javierfileiv/gaspetto/datasheet/YP-05-serial-usb-pinout.png

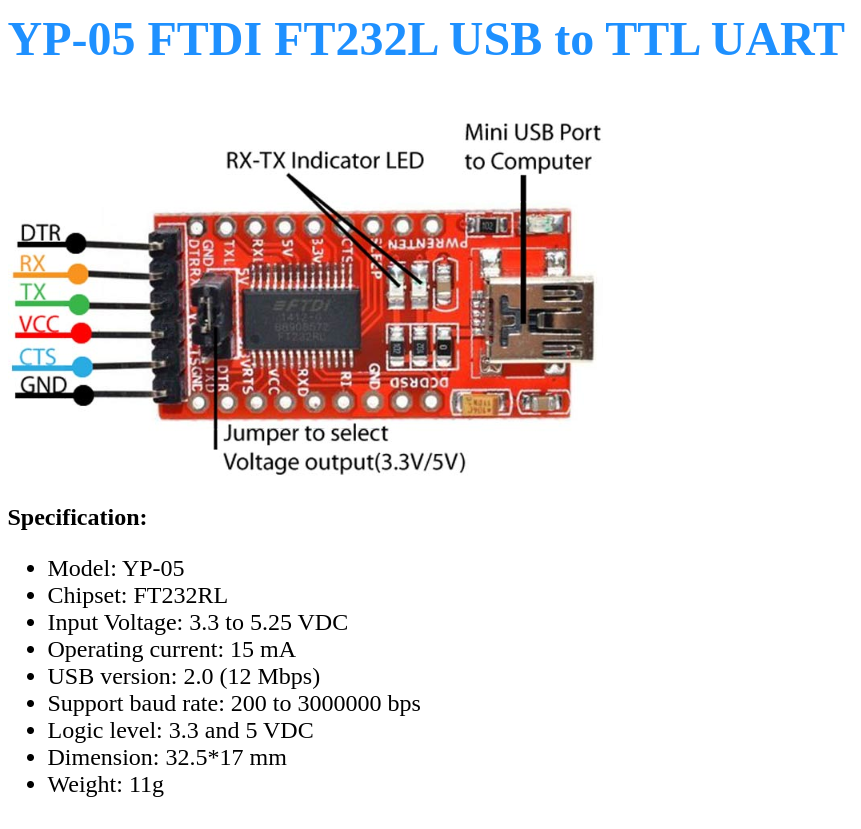
datasheet/YP-05-serial-usb-pinout.png
