javierfileiv/gaspetto/datasheet/convertisseur.png

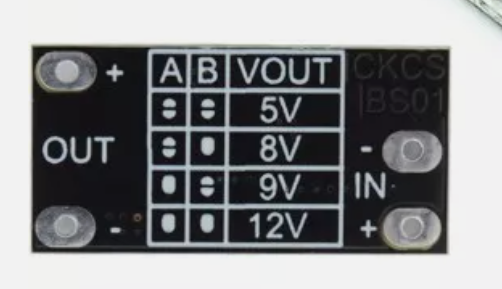
datasheet/convertisseur.png
