javierfileiv/gaspetto/datasheet/blackpill limitation.png

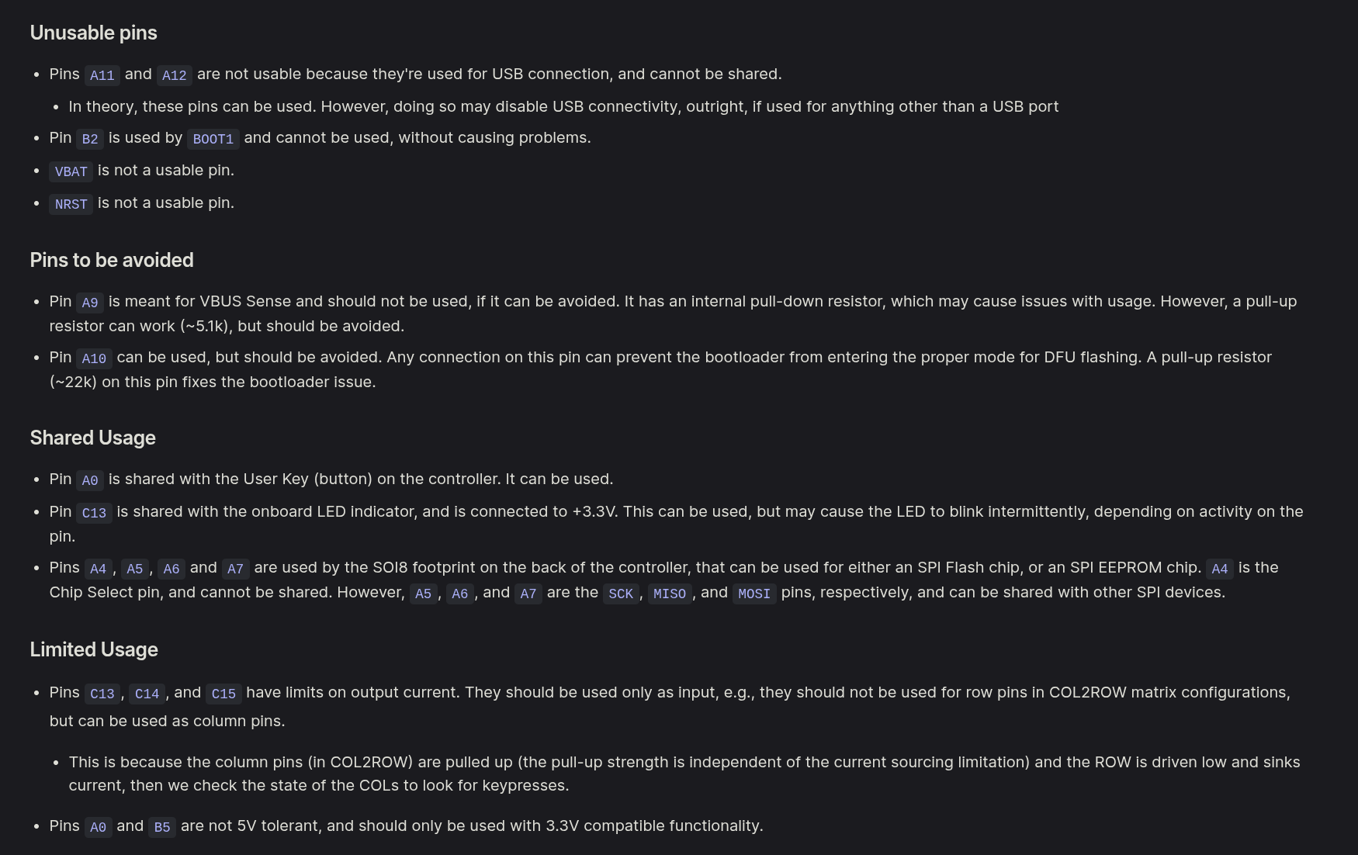
datasheet/blackpill limitation.png
