javierfileiv/gaspetto/datasheet/bluepill_sch.jpg

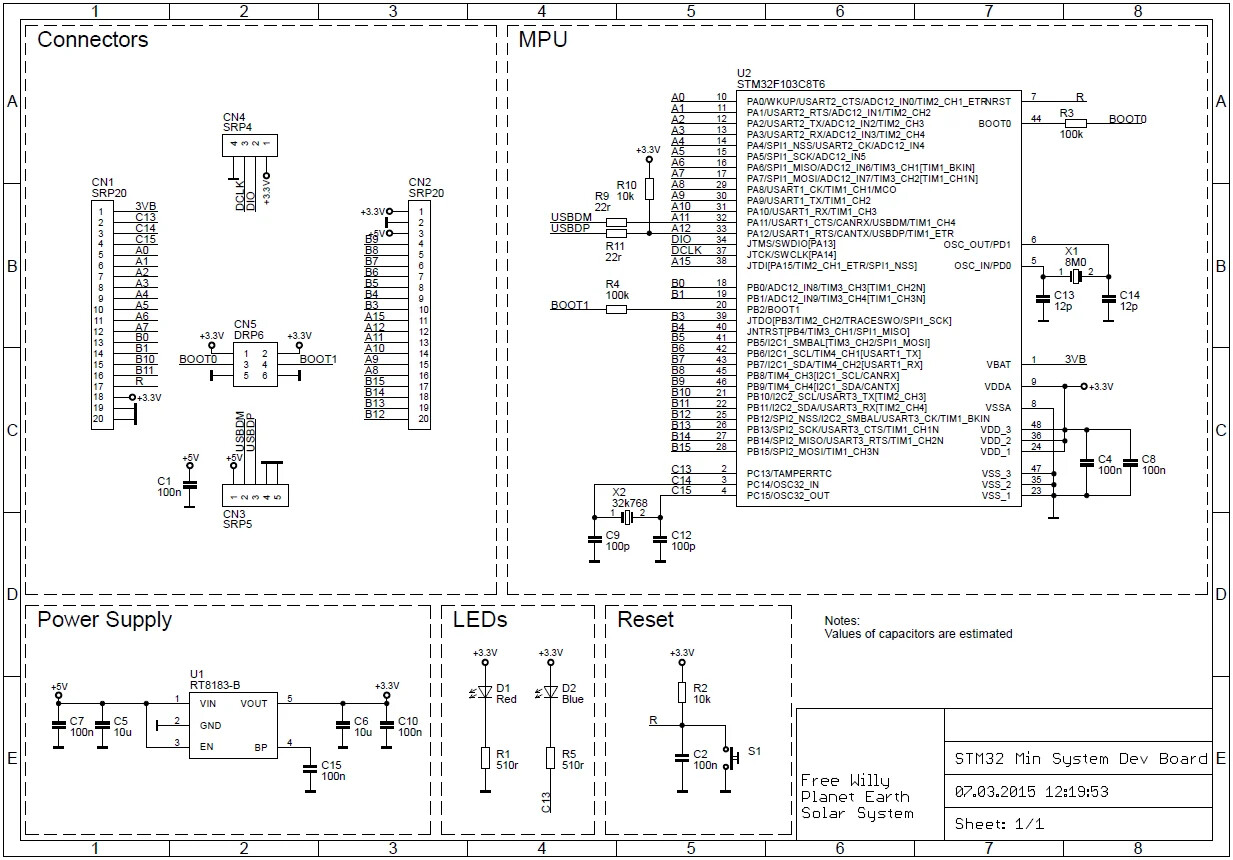
datasheet/bluepill_sch.jpg
