javierfileiv/gaspetto/datasheet/interface bluepill nrf.png

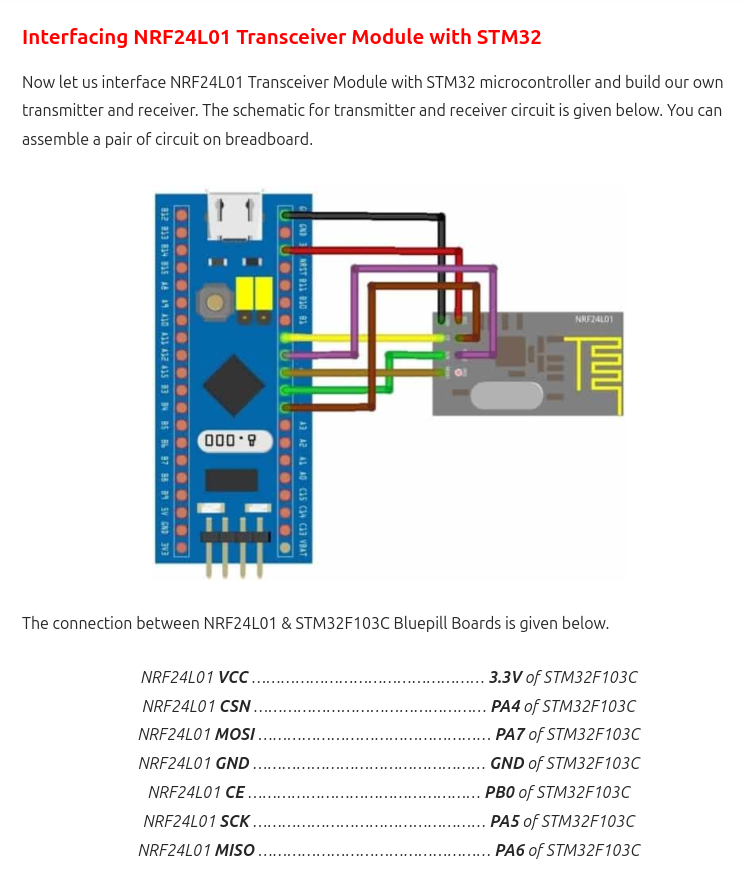
datasheet/interface bluepill nrf.png
