javierfileiv/gaspetto/datasheet/L9110-possible-sch.png

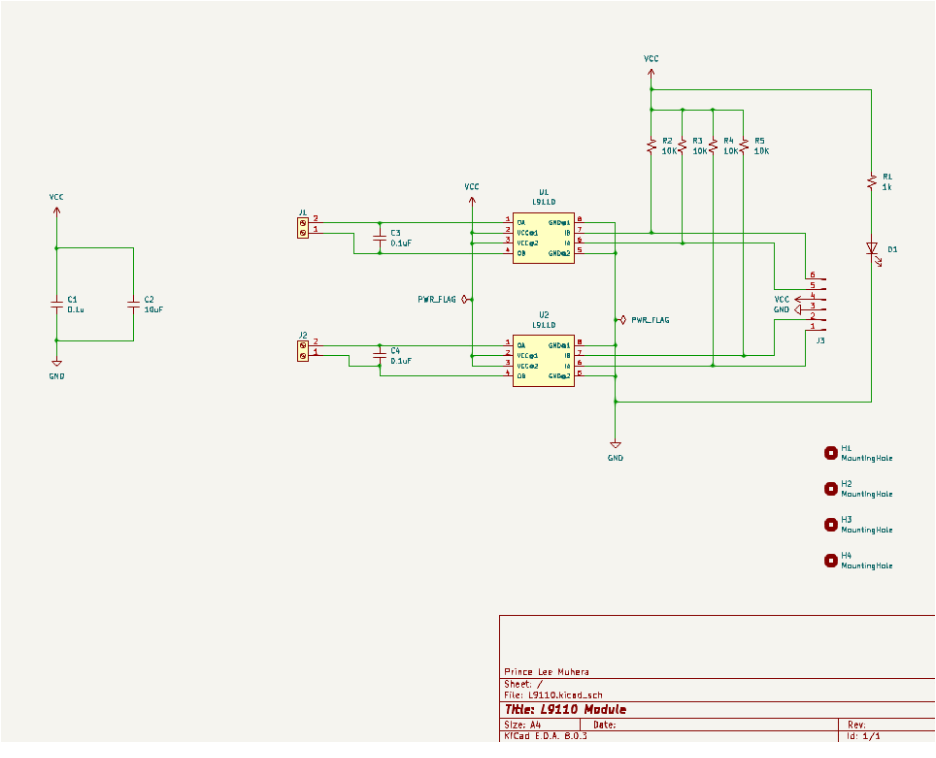
datasheet/L9110-possible-sch.png
