javierfileiv/gaspetto/datasheet/L9110-puenteH.png

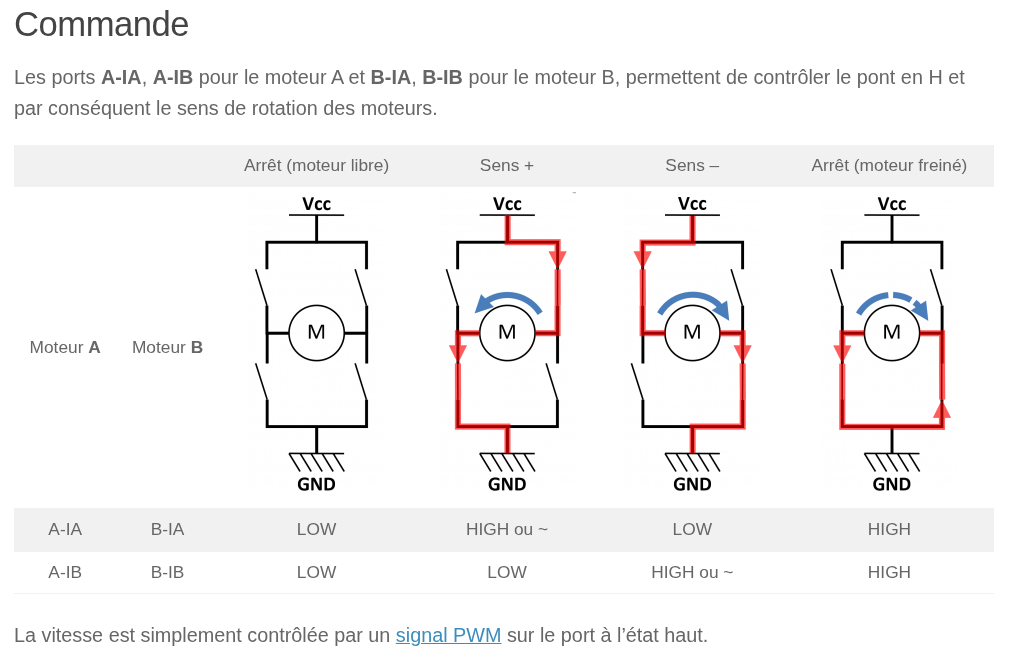
datasheet/L9110-puenteH.png
