javierfileiv/gaspetto/datasheet/l9110_breakout.jpg

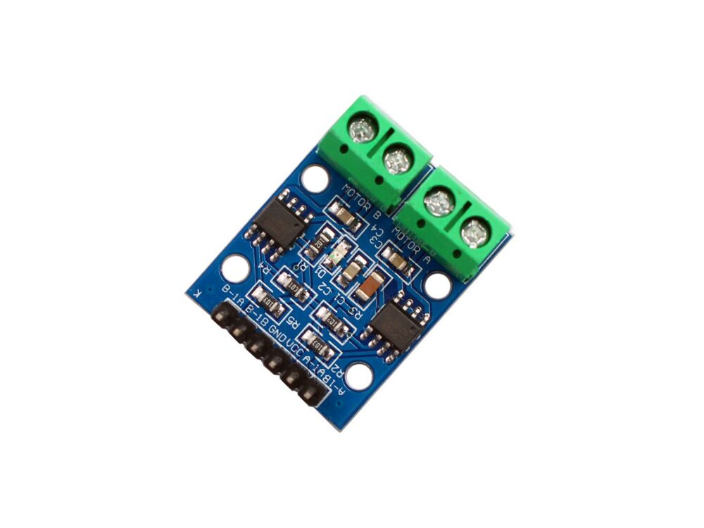
datasheet/l9110_breakout.jpg
