javierfileiv/gaspetto/datasheet/NRF24L01-pinout.png

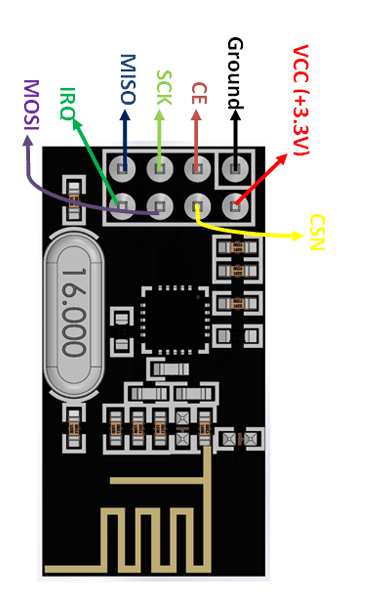
datasheet/NRF24L01-pinout.png
