javierfileiv/gaspetto/datasheet/optical_speed_sensor.png

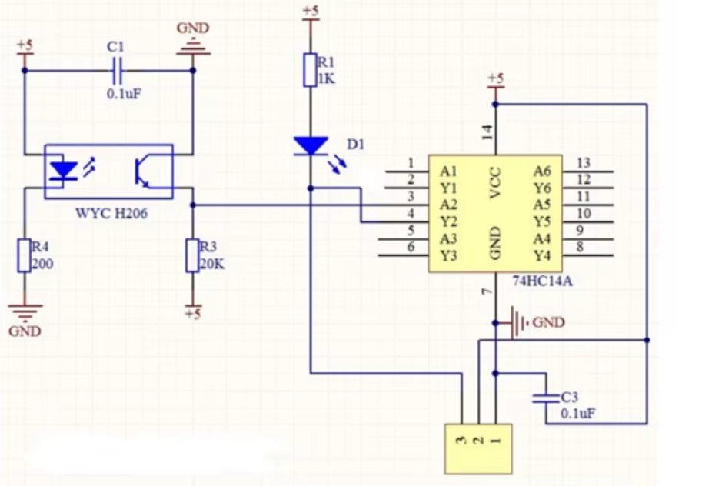
datasheet/optical_speed_sensor.png
