javierfileiv/gaspetto/datasheet/Speed Measuring Sensor- Encoder Counter.png

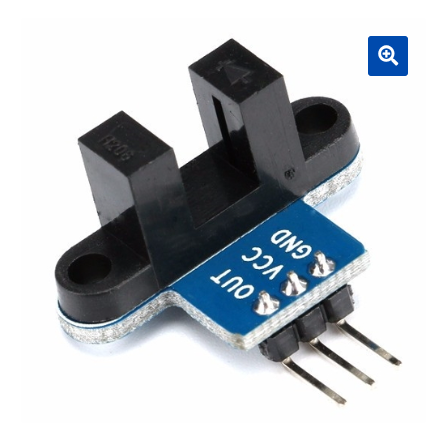
datasheet/Speed Measuring Sensor- Encoder Counter.png
