javierfileiv/gaspetto/FreeCad/Franco/Plan de travail 1.jpg

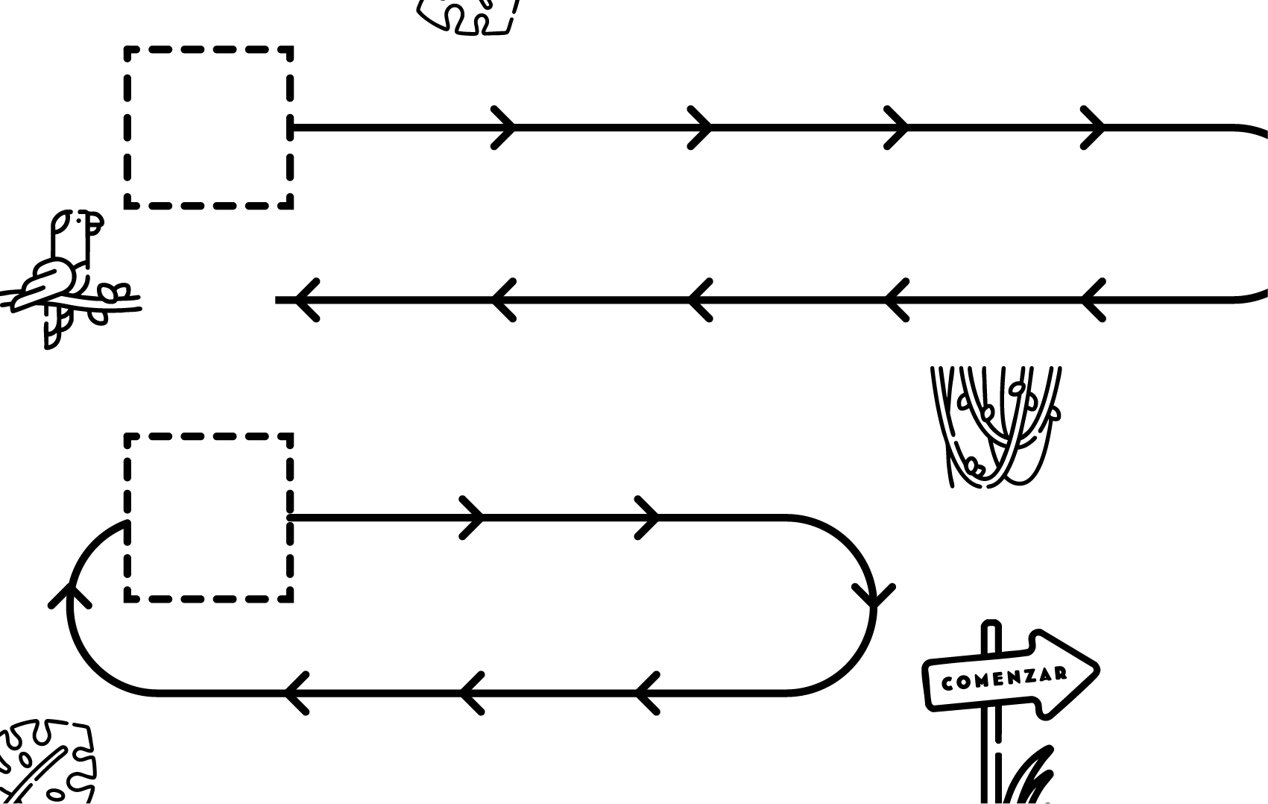
FreeCad/Franco/Plan de travail 1.jpg
