javierfileiv/gaspetto/FreeCad/Franco/Plan de travail 3.jpg

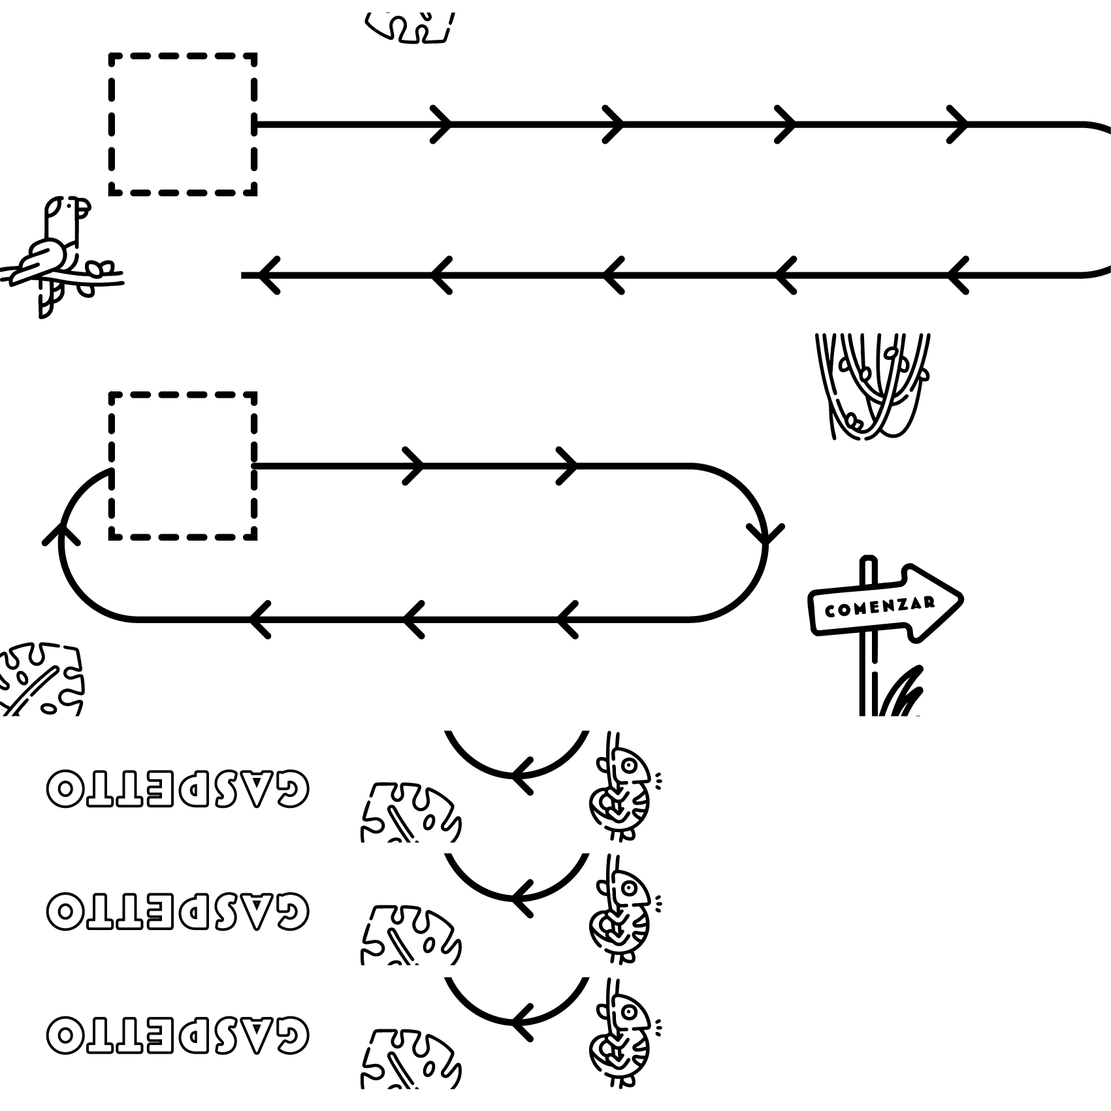
FreeCad/Franco/Plan de travail 3.jpg
