javierfileiv/gaspetto/FreeCad/gaspetto-box.FCStd

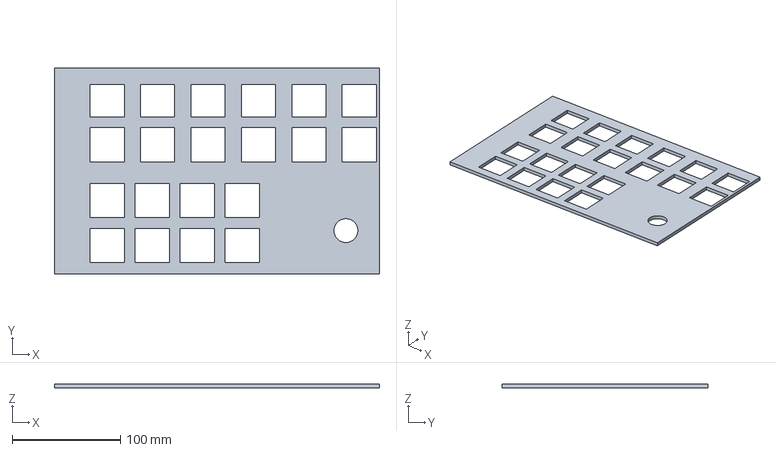
[picture p14: CAD file, 2026-04-30]
FreeCad/gaspetto-box.FCStd
300.0 x 190.0 x 4.00 mm
