javierfileiv/gaspetto/primo-prototype-laser/CubettoCloneBits/left_top2.stl

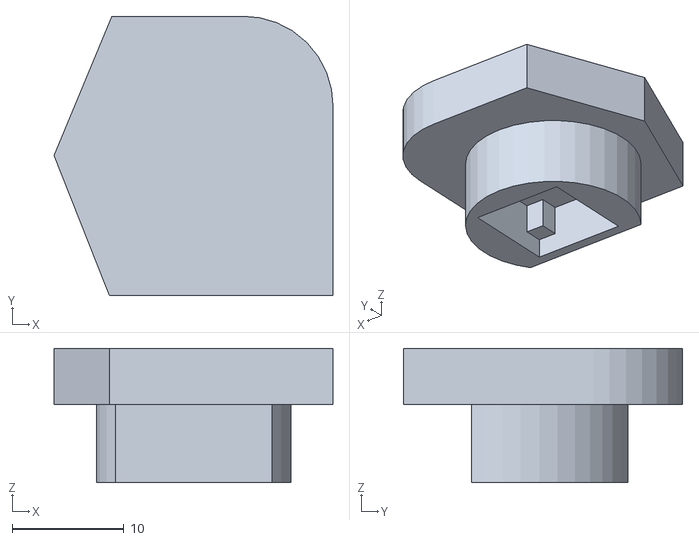
[picture p15: CAD file, 2023-08-26]
primo-prototype-laser/CubettoCloneBits/left_top2.stl
25.0 x 25.0 x 12.0
