javierfileiv/gaspetto/primo-prototype-laser/laser-cut-LibreCAD/original/tree-4mm.dxf

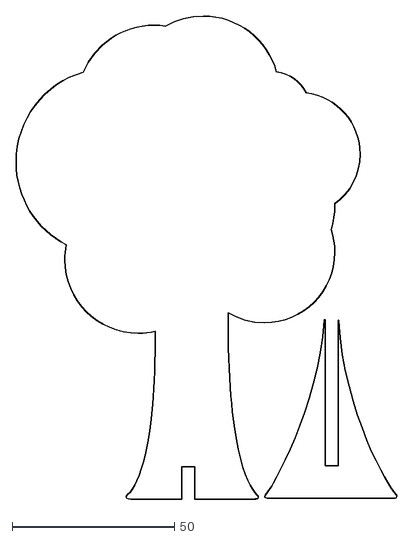
[picture p16: CAD file, 2023-08-26]
primo-prototype-laser/laser-cut-LibreCAD/original/tree-4mm.dxf
118.7 x 149.3
