javierfileiv/gaspetto/primo-prototype-laser/CubettoCloneBits/left_top_v2.stl

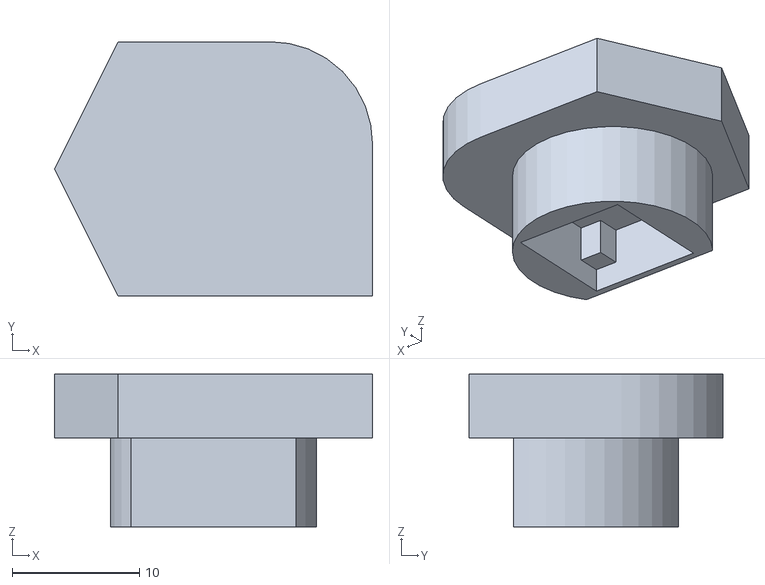
[picture p17: CAD file, 2023-08-26]
primo-prototype-laser/CubettoCloneBits/left_top_v2.stl
25.0 x 20.0 x 12.0
