javierfileiv/gaspetto/primo-prototype-laser/laser-cut-LibreCAD/InstructionsBlock/#instruction-blocks-1mm.dxf

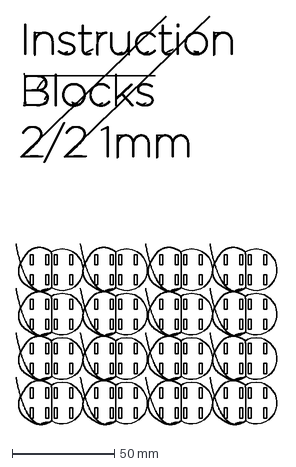
[picture p18: CAD file, 2023-08-26]
primo-prototype-laser/laser-cut-LibreCAD/InstructionsBlock/#instruction-blocks-1mm.dxf
128.8 x 200.3 mm
