javierfileiv/gaspetto/primo-prototype-laser/laser-cut-LibreCAD/original/instruction-blocks-4mm.dxf

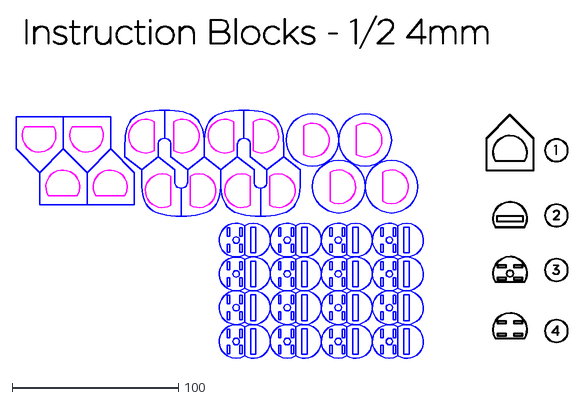
[picture p19: CAD file, 2023-08-26]
primo-prototype-laser/laser-cut-LibreCAD/original/instruction-blocks-4mm.dxf
332.0 x 207.2
