javierfileiv/gaspetto/primo-prototype-laser/CubettoCloneBits/left_top.stl

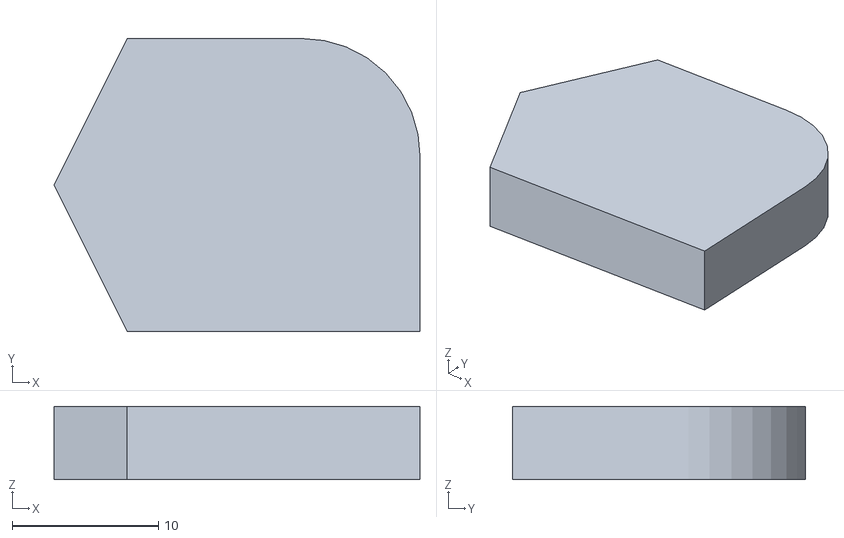
[picture p20: CAD file, 2023-08-26]
primo-prototype-laser/CubettoCloneBits/left_top.stl
25.0 x 20.0 x 5.00
