javierfileiv/gaspetto/primo-prototype-laser/laser-cut-LibreCAD/original/house-3mm.dxf

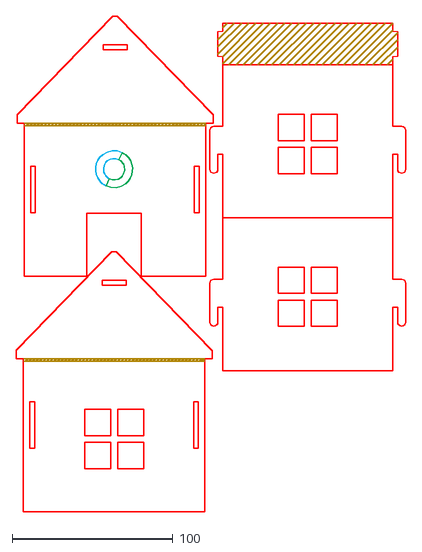
[picture p21: CAD file, 2023-08-26]
primo-prototype-laser/laser-cut-LibreCAD/original/house-3mm.dxf
242.7 x 308.5
