javierfileiv/gaspetto/primo-prototype-laser/laser-cut-LibreCAD/original/interface-board-1mm.dxf

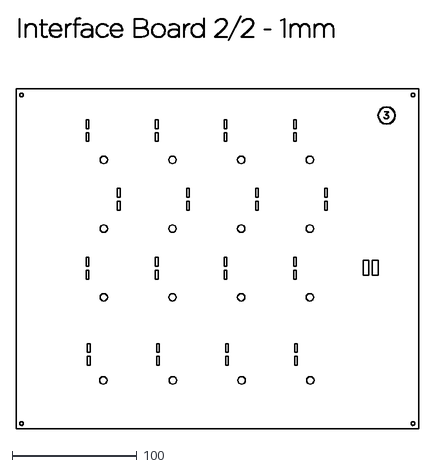
[picture p22: CAD file, 2023-08-26]
primo-prototype-laser/laser-cut-LibreCAD/original/interface-board-1mm.dxf
322.1 x 330.4
