javierfileiv/gaspetto/primo-prototype-laser/laser-cut-LibreCAD/original/instruction-blocks-1mm.dxf

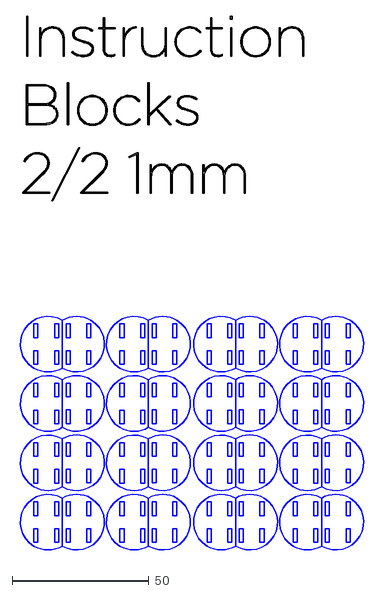
[picture p23: CAD file, 2023-08-26]
primo-prototype-laser/laser-cut-LibreCAD/original/instruction-blocks-1mm.dxf
128.2 x 196.3
