javierfileiv/gaspetto/primo-prototype-laser/laser-cut-LibreCAD/original/fence-4mm.dxf

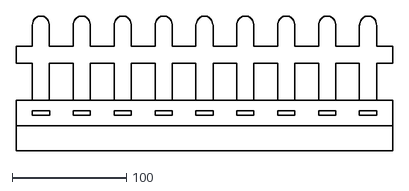
[picture p24: CAD file, 2023-08-26]
primo-prototype-laser/laser-cut-LibreCAD/original/fence-4mm.dxf
330.0 x 118.1
