javierfileiv/gaspetto/primo-prototype-laser/laser-cut-LibreCAD/original/cubetto-4mm.dxf

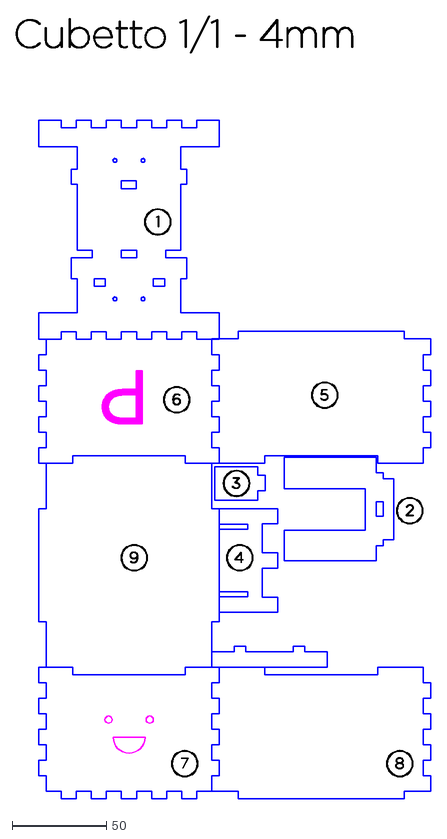
[picture p25: CAD file, 2023-08-26]
primo-prototype-laser/laser-cut-LibreCAD/original/cubetto-4mm.dxf
220.2 x 415.9
