javierfileiv/gaspetto/primo-prototype-laser/laser-cut-LibreCAD/original/interface-board-4mm.dxf

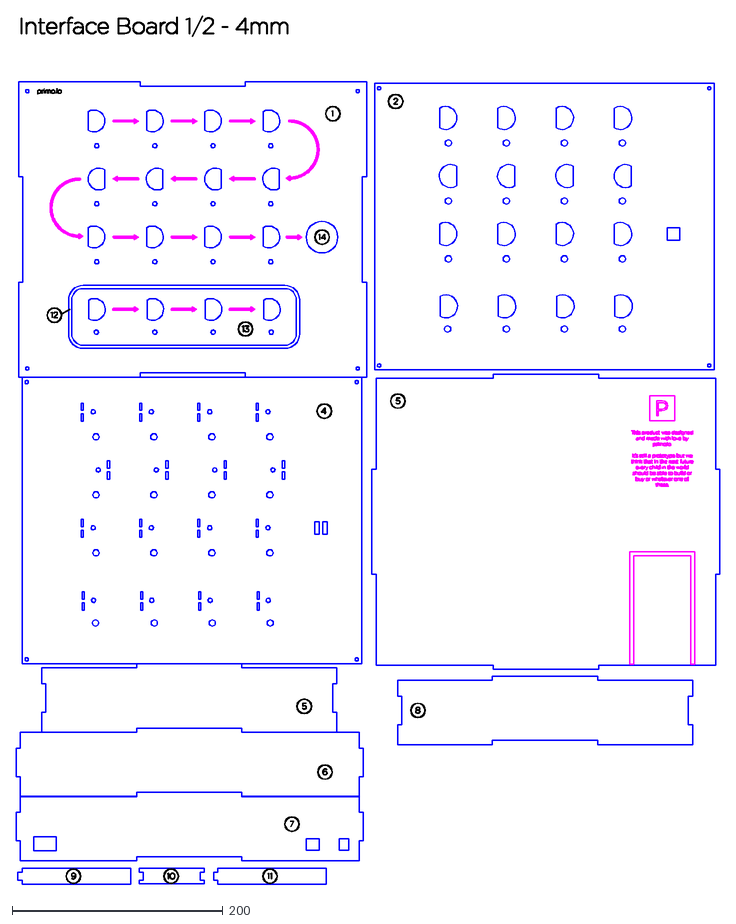
[picture p26: CAD file, 2023-08-26]
primo-prototype-laser/laser-cut-LibreCAD/original/interface-board-4mm.dxf
667.8 x 823.7
