javierfileiv/gaspetto/(list of files, cad)

Other CAD files:
primo-prototype-laser/laser-cut-LibreCAD/InstructionsBlock/#instruction-blocks-4mm.dxf
primo-prototype-laser/laser-cut-LibreCAD/interface-board/interface-board-4mm.dxf
primo-prototype-laser/laser-cut-LibreCAD/interface-board/interface-board-1mm.dxf
primo-prototype-laser/laser-cut-LibreCAD/InstructionsBlock/instruction-blocks-1mm.dxf
