javierfileiv/gaspetto/soft/Tests/arduino-tests/nrf24_rx_tx/rx_tx_tested_WORKING/details_ALICE.md

details_ALICE.txt

0 20 20 20 20 11 0 0 1 1F C C4 1A"
CE pin____________________287
CSN pin___________________3268
SPI speed_________________10 MHz
Is a plus variant_________True
Channel___________________76 ~ 2.476 GHz
RF Data Rate______________1 Mbps
RF Power Amplifier________PA_MIN
RF Low Noise Amplifier____Enabled
CRC Length________________16 bits
Address length____________5 bytes
TX Payload lengths________32 bytes
Auto retry delay__________1500 microseconds
Auto retry attempts_______15 maximum
Re-use TX FIFO____________False
Received Power Detected___False
Packets lost on current channel_____________________0
Retry attempts made for last transmission___________3
IRQ on Data Ready___Enabled    Data Ready___________False
IRQ on Data Sent____Enabled    Data Sent____________False
IRQ on Data Fail____Enabled    Data Failed__________False
TX FIFO full__________False    TX FIFO empty________True
RX FIFO full__________False    RX FIFO empty________True
Multicast__________Disabled    Custom ACK Payload___Disabled
Dynamic Payloads___Disabled    Auto Acknowledgment__Enabled
Primary Mode_____________TX    Power Mode___________Standby
TX address____________ 0x65E7E7E7E7
Pipe 0 ( open ) bound: 0x65E7E7E7E7
                expecting 32 byte static payloads
Pipe 1 ( open ) bound: 0x65ADDEADDE
                expecting 32 byte static payloads
Pipe 2 (closed) bound: 0x65ADDEAD02
Pipe 3 (closed) bound: 0x65ADDEAD03
Pipe 4 (closed) bound: 0x65ADDEAD04
Pipe 5 (closed) bound: 0x65ADDEAD05
