javierfileiv/gaspetto/FreeCad/Franco/Plan de travail 1.pdf

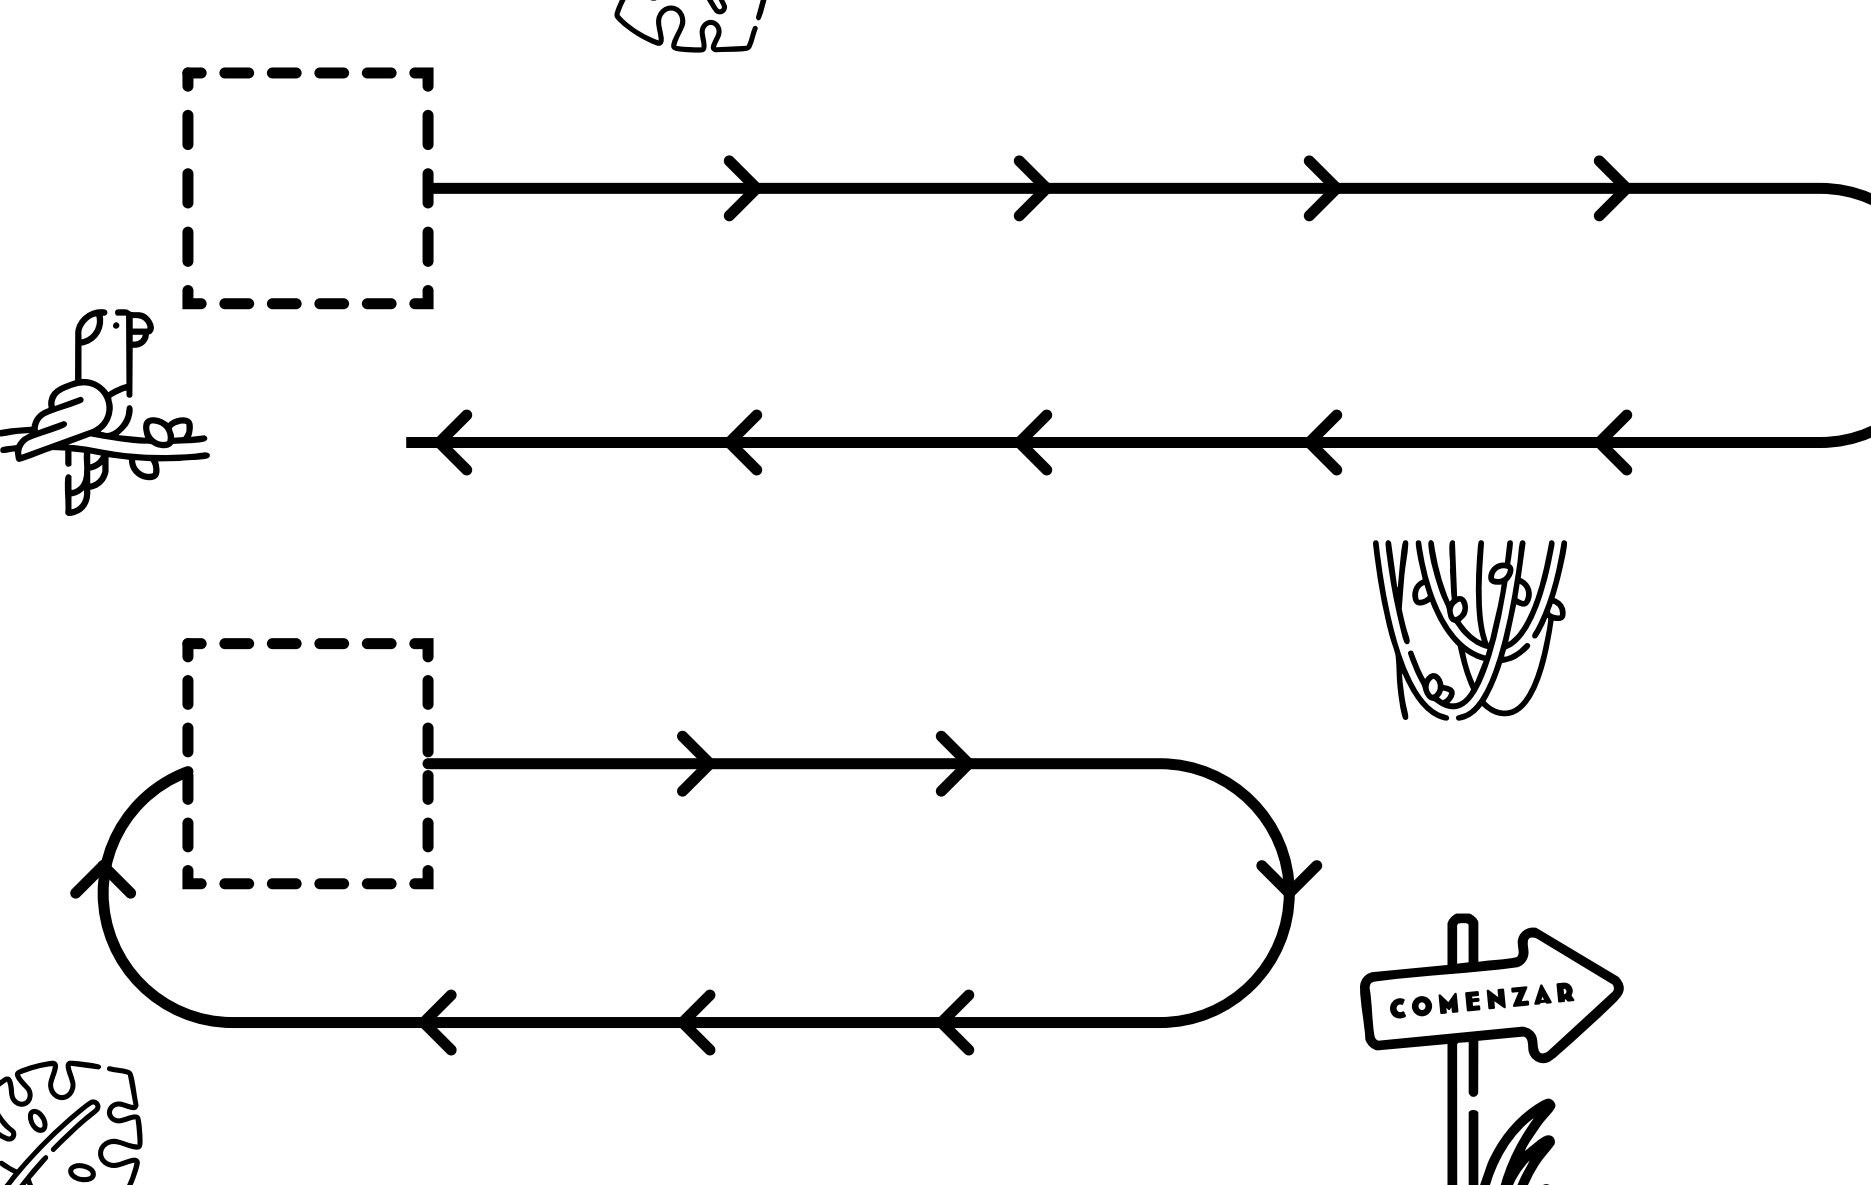
[picture p27: page 1]
