javierfileiv/gaspetto/FreeCad/Franco/Plan de travail 3.pdf

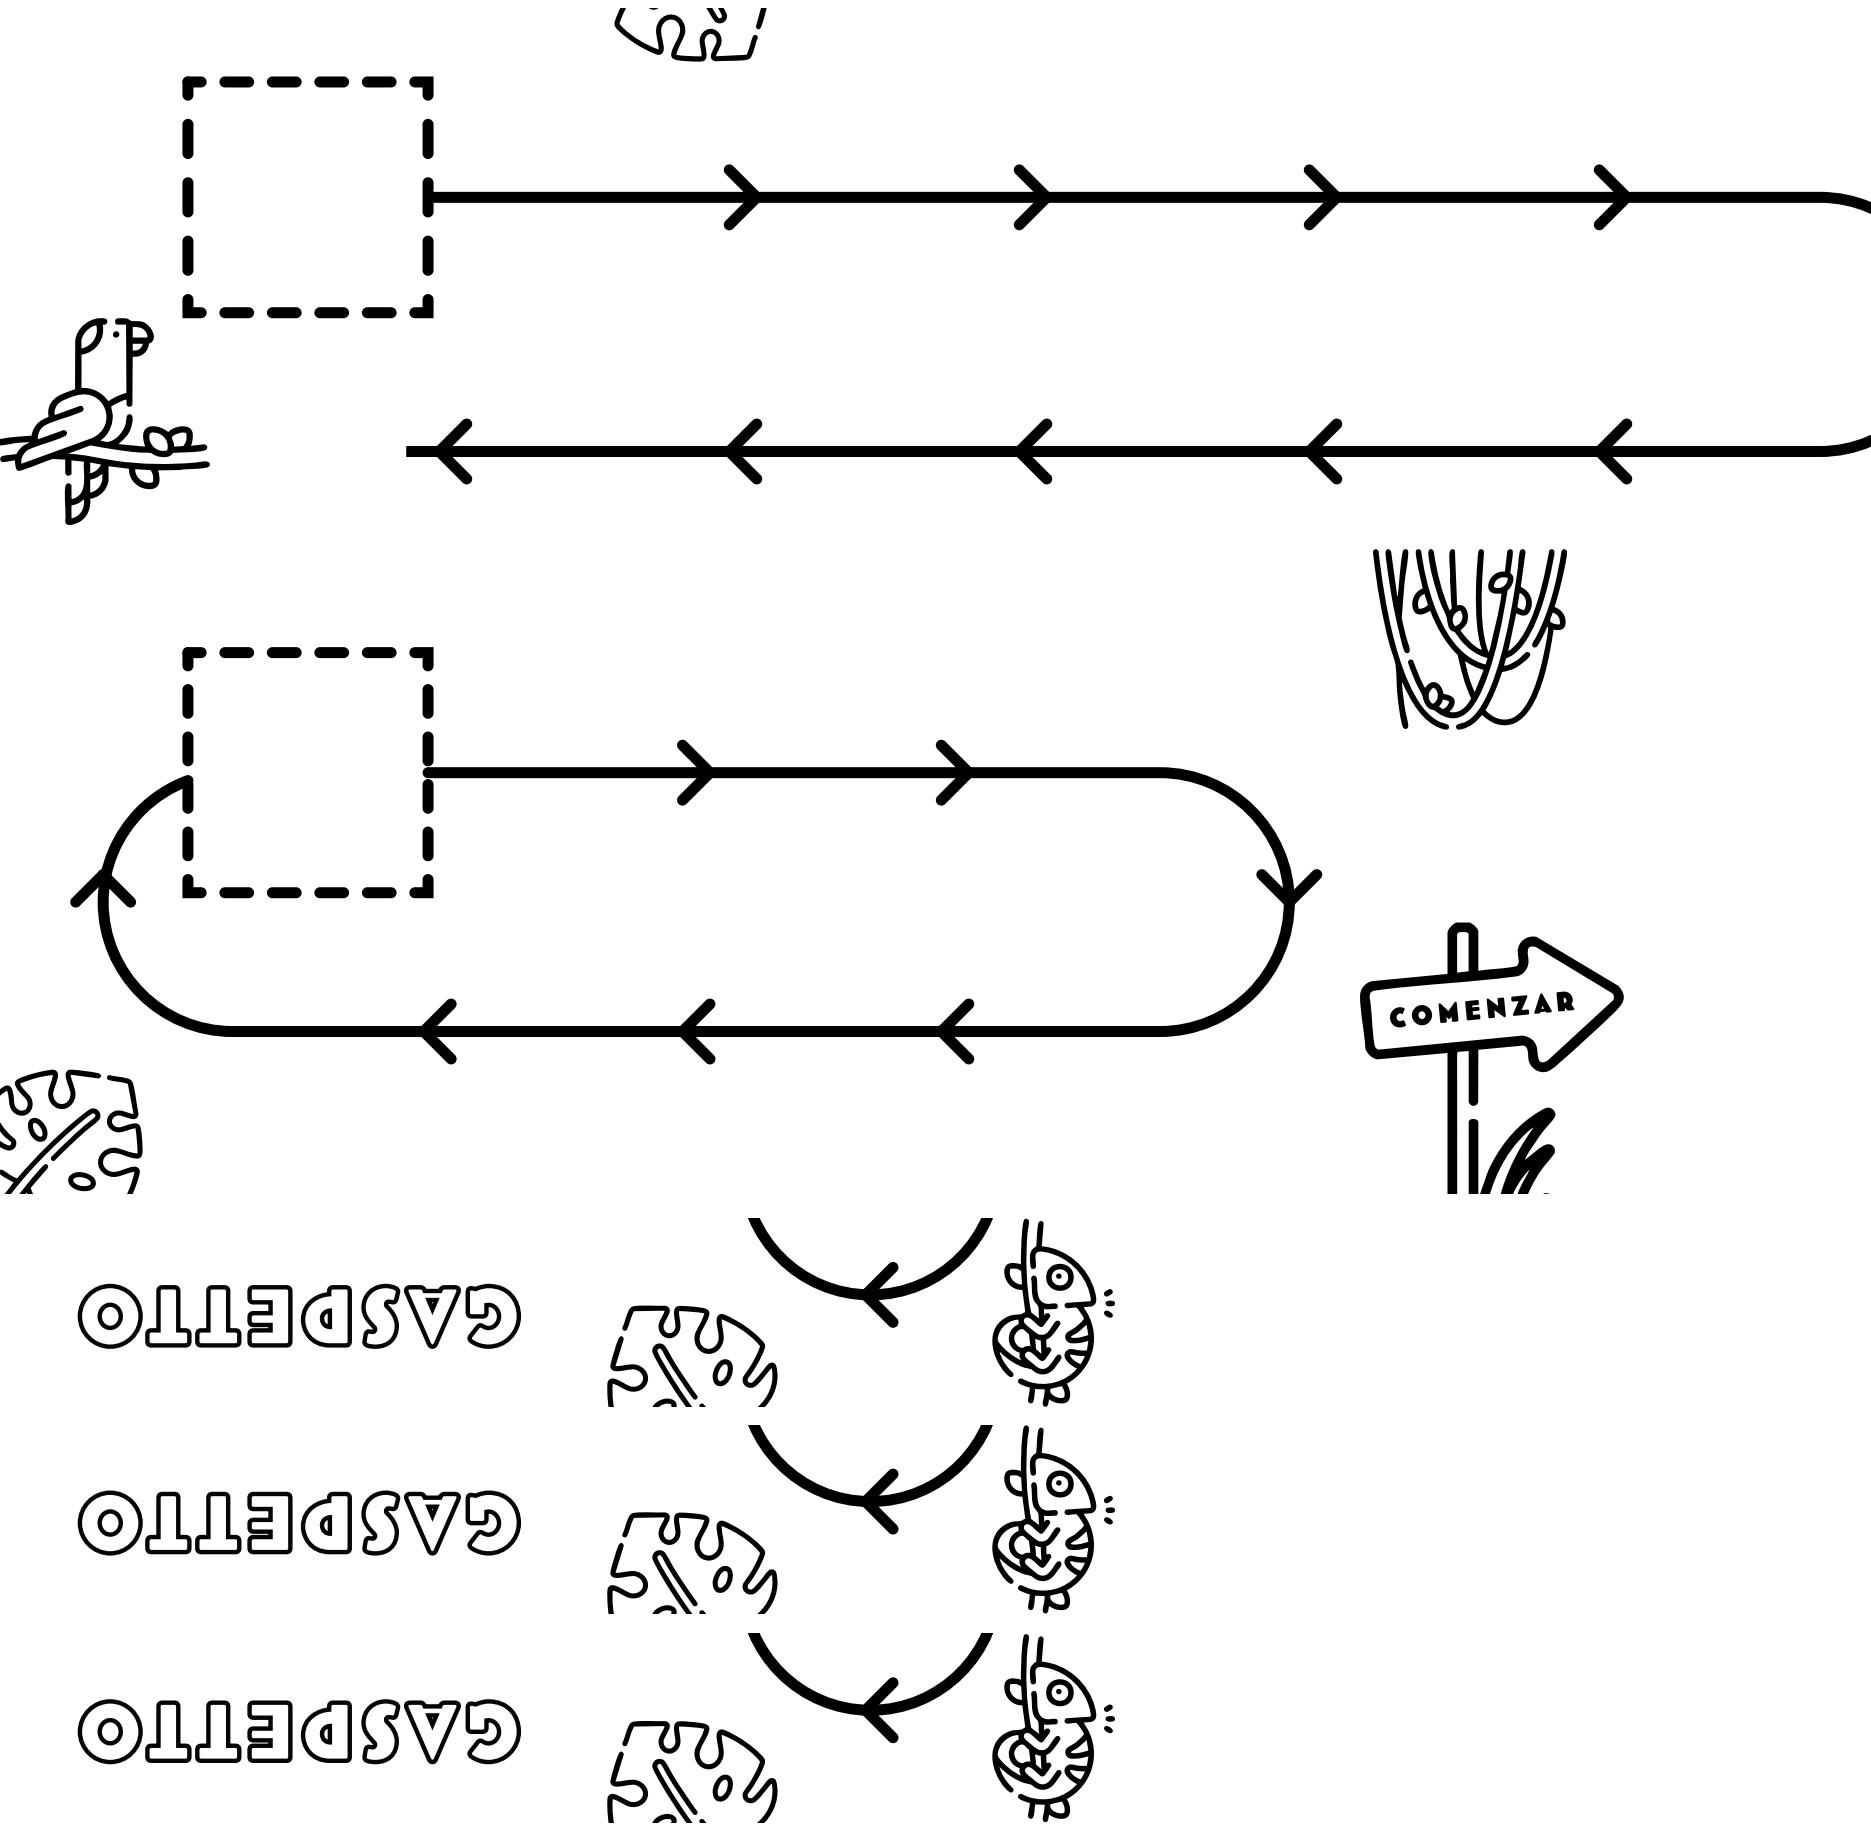
[picture p28: page 1]
