javierfileiv/gaspetto/kicad/prototipo-stm32-nrf24l01/prototipo_gaspetto_box.kicad_sch

## KiCad design kicad/prototipo-stm32-nrf24l01/prototipo_gaspetto_box.kicad_sch (2026-10-27)

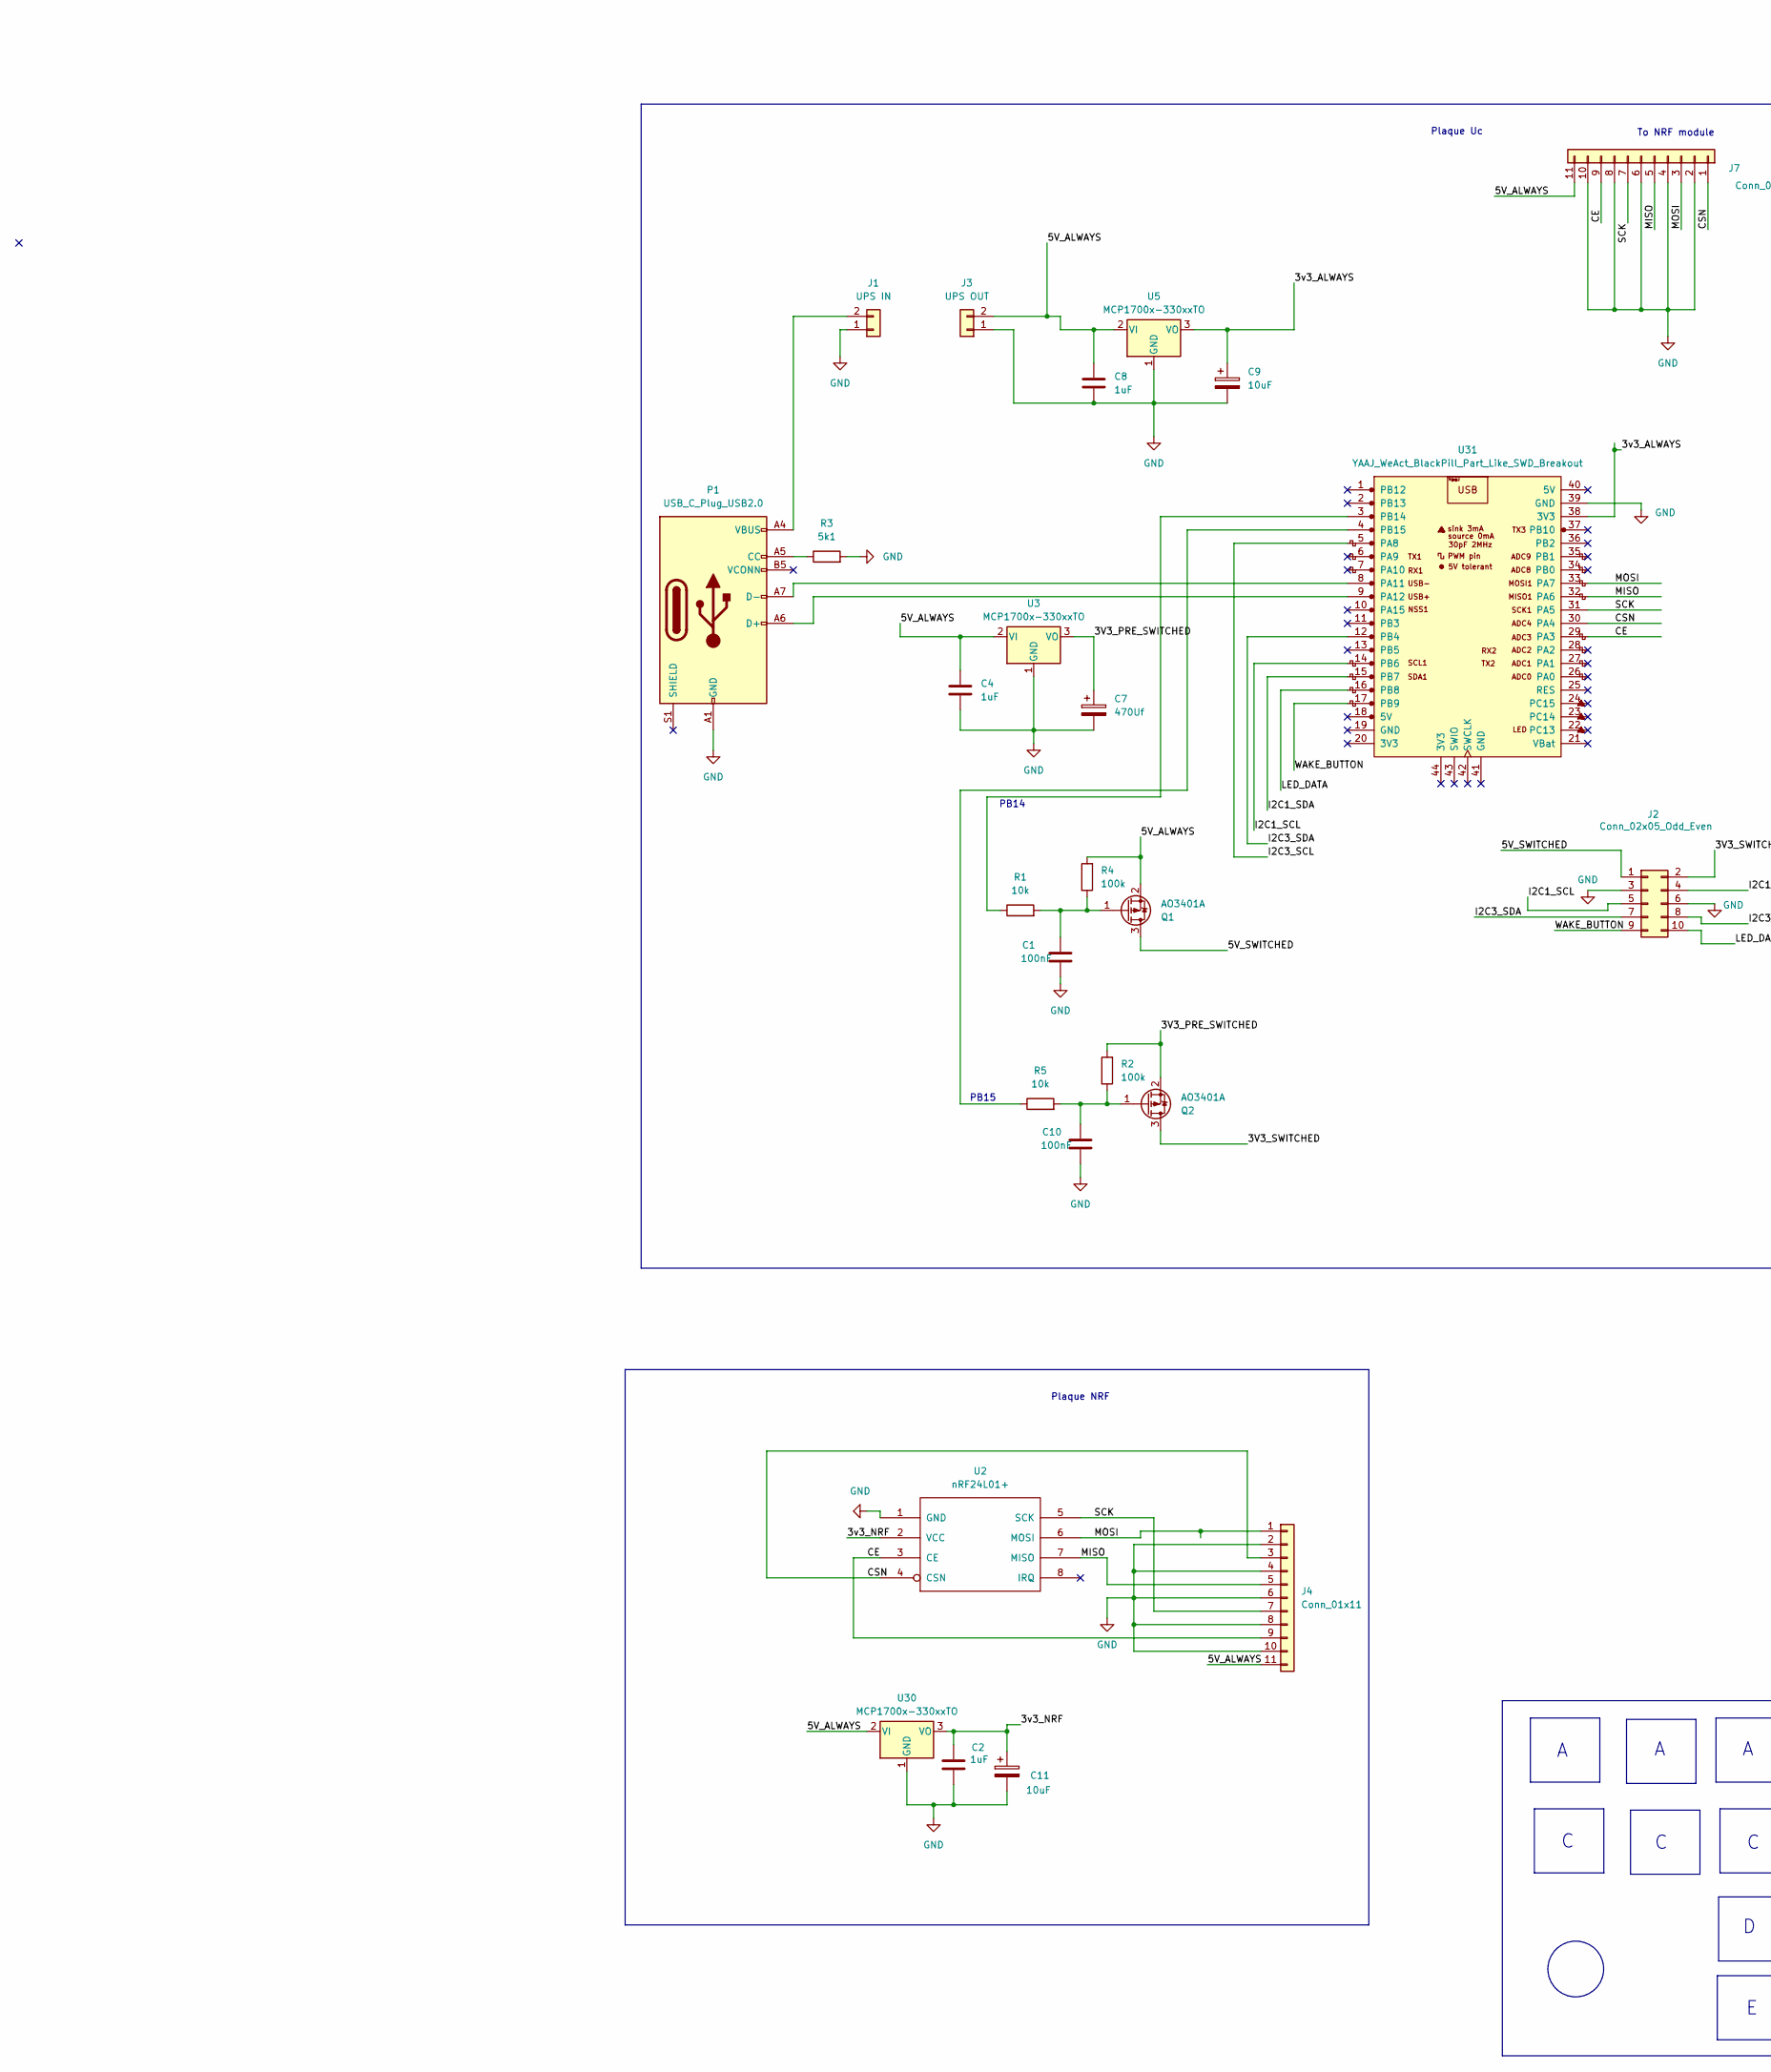
[picture p29: schematic prototipo_gaspetto_box.kicad_sch, part in row 1, column 1]

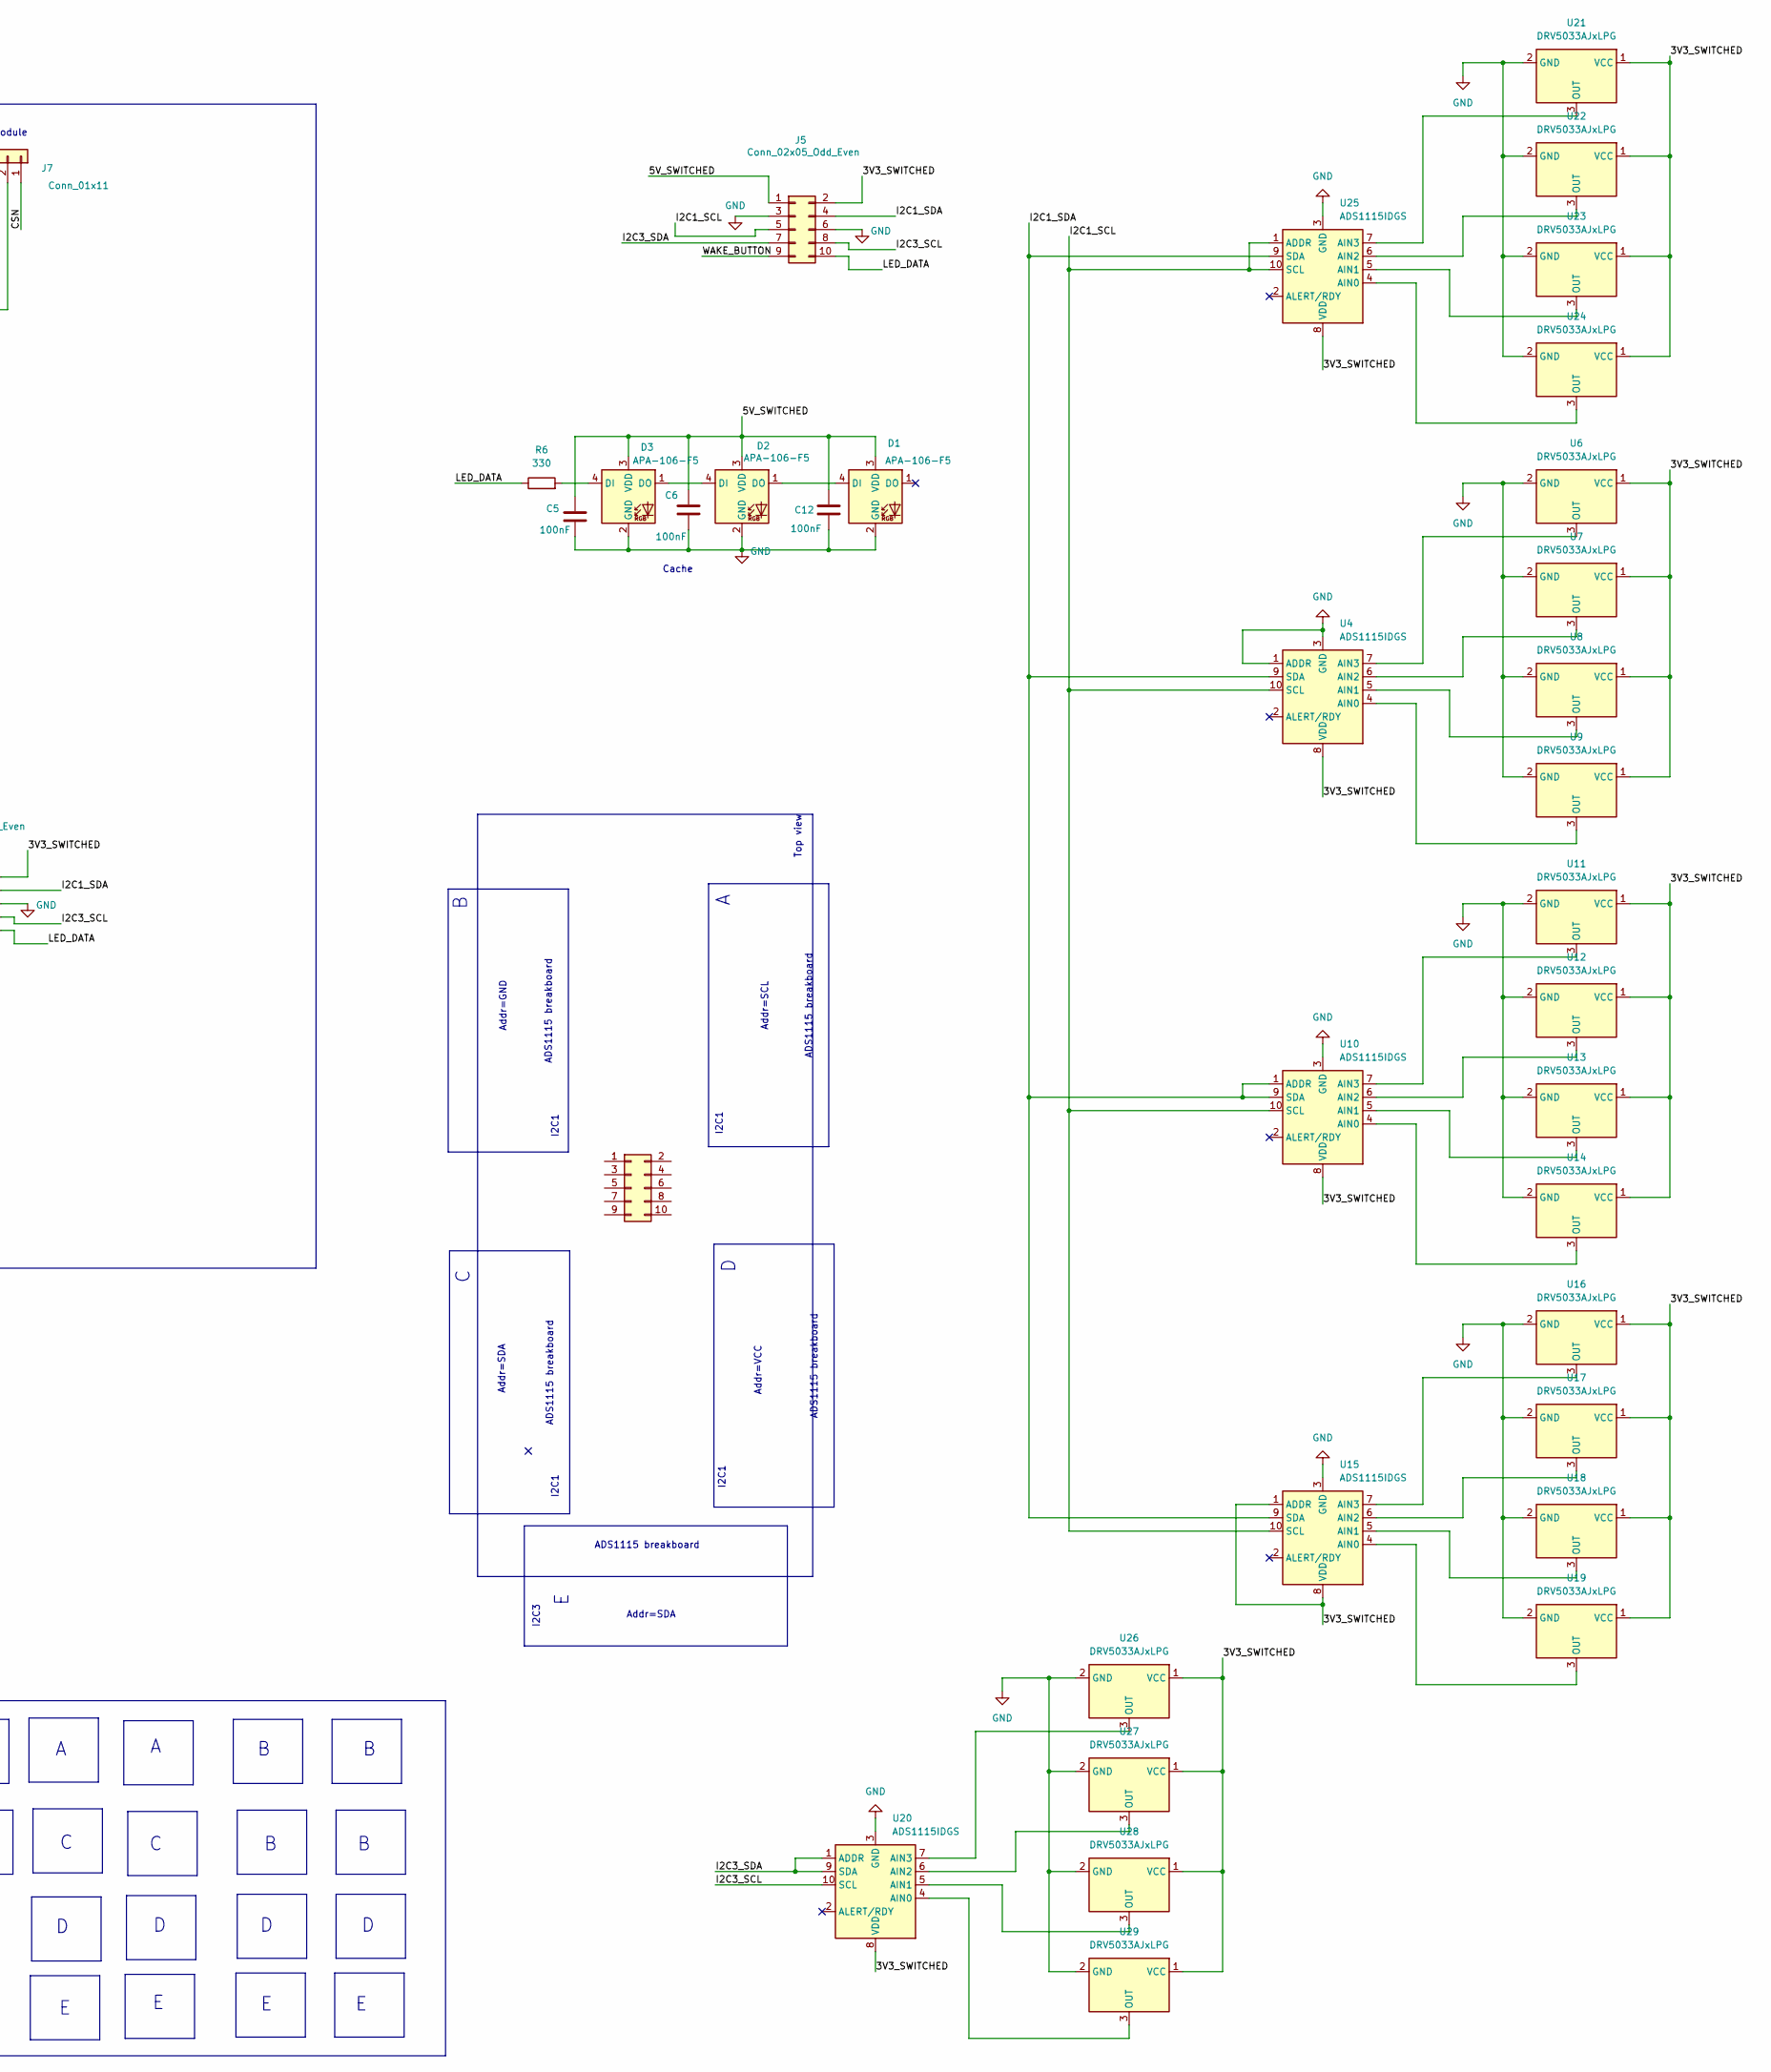
[picture p30: schematic prototipo_gaspetto_box.kicad_sch, part in row 1, column 2]

Parts:
C1: 100nF; CP_Axial_L10.0mm_D4.5mm_P15.00mm_Horizontal
C2, C4, C8: 1uF; C_Radial_D8.0mm_H11.5mm_P3.50mm
C5, C6, C10, C12: 100nF; CP_Radial_D4.0mm_P1.50mm
C7: 470Uf; C_Radial_D8.0mm_H11.5mm_P3.50mm
C9, C11: 10uF; C_Radial_D8.0mm_H11.5mm_P3.50mm
D1, D2, D3: APA-106-F5; LED_D5.0mm-4_RGB
J1: UPS IN; PinHeader_1x02_P1.27mm_Horizontal
J2, J5, J6: Conn_02x05_Odd_Even; PinHeader_2x05_P1.27mm_Vertical
J3: UPS OUT; PinHeader_1x02_P1.27mm_Vertical
J4, J7: Conn_01x11; PinHeader_1x11_P1.27mm_Vertical
P1: USB_C_Plug_USB2.0; USB_C_Receptacle_XKB_U262-16XN-4BVC11
Q1, Q2: AO3401A; SOT-23
R1, R5: 10k; R_Axial_DIN0309_L9.0mm_D3.2mm_P12.70mm_Horizontal
R2, R4: 100k; R_Axial_DIN0309_L9.0mm_D3.2mm_P12.70mm_Horizontal
R3: 5k1; R_Axial_DIN0309_L9.0mm_D3.2mm_P12.70mm_Horizontal
R6: 330; R_Axial_DIN0309_L9.0mm_D3.2mm_P12.70mm_Horizontal
U2: nRF24L01+; PinHeader_2x04_P2.54mm_Vertical
U3, U5, U30: MCP1700x-330xxTO; TO-92_Inline
U4, U10, U15, U20, U25: ADS1115IDGS; TSSOP-10_3x3mm_P0.5mm
U6, U7, U8, U9, U11, U12, U13, U14, U16, U17, U18, U19, U21, U22, U23, U24, U26, U27, U28, U29: DRV5033AJxLPG; TO-92_Inline
U31: YAAJ_WeAct_BlackPill_Part_Like_SWD_Breakout; DIP-40_W25.4mm_LongPads

Connections:
3V3_PRE_SWITCHED: C7.1, Q2.2 (S), R2.2, U3.3 (VO)
3V3_SWITCHED: J2.2, J5.2, Q2.3 (D), U4.8 (VDD), U6.1 (VCC), U7.1 (VCC), U8.1 (VCC), U9.1 (VCC), U10.8 (VDD), U11.1 (VCC), U12.1 (VCC), U13.1 (VCC), U14.1 (VCC), U15.1 (ADDR), U15.8 (VDD), U16.1 (VCC), U17.1 (VCC), U18.1 (VCC), U19.1 (VCC), U20.8 (VDD), U21.1 (VCC), U22.1 (VCC), U23.1 (VCC), U24.1 (VCC), U25.8 (VDD), U26.1 (VCC), U27.1 (VCC), U28.1 (VCC), U29.1 (VCC)
3v3_ALWAYS: C9.1, U5.3 (VO), U31.38 (3V3)
3v3_NRF: C2.1, C11.1, U2.2 (VCC), U30.3 (VO)
5V_ALWAYS: C4.1, C8.1, J3.2, J4.11, J7.11, Q1.2 (S), R4.2, U3.2 (VI), U5.2 (VI), U30.2 (VI)
5V_SWITCHED: C5.1, C6.1, C12.1, D1.3 (VDD), D2.3 (VDD), D3.3 (VDD), J2.1, J5.1, Q1.3 (D)
CE: J4.9, J7.9, U2.3 (CE), U31.29 (PA3)
CSN: J4.3, J7.1, U2.4 (CSN), U31.30 (PA4)
GND: C1.2, C2.2, C4.2, C5.2, C6.2, C7.2, C8.2, C9.2, C10.2, C11.2, C12.2, D1.2 (GND), D2.2 (GND), D3.2 (GND), J1.1, J2.3, J2.6, J3.1, J4.2, J4.4, J4.6, J4.8, J4.10, J5.3, J5.6, J7.2, J7.4, J7.6, J7.8, J7.10, P1.A1 (GND), P1.A12 (GND), P1.B1 (GND), P1.B12 (GND), R3.2, U2.1 (GND), U3.1 (GND), U4.1 (ADDR), U4.3 (GND), U5.1 (GND), U6.2 (GND), U7.2 (GND), U8.2 (GND), U9.2 (GND), U10.3 (GND), U11.2 (GND), U12.2 (GND), U13.2 (GND), U14.2 (GND), U15.3 (GND), U16.2 (GND), U17.2 (GND), U18.2 (GND), U19.2 (GND), U20.3 (GND), U21.2 (GND), U22.2 (GND), U23.2 (GND), U24.2 (GND), U25.3 (GND), U26.2 (GND), U27.2 (GND), U28.2 (GND), U29.2 (GND), U30.1 (GND), U31.39 (GND)
I2C1_SCL: J2.5, J5.5, U4.10 (SCL), U10.10 (SCL), U15.10 (SCL), U25.1 (ADDR), U25.10 (SCL), U31.14 (PB6)
I2C1_SDA: J2.4, J5.4, U4.9 (SDA), U10.1 (ADDR), U10.9 (SDA), U15.9 (SDA), U25.9 (SDA), U31.15 (PB7)
I2C3_SCL: J2.8, J5.8, U20.10 (SCL), U31.5 (PA8)
I2C3_SDA: J2.7, J5.7, U20.1 (ADDR), U20.9 (SDA), U31.12 (PB4)
LED_DATA: J2.10, J5.10, R6.1, U31.16 (PB8)
MISO: J4.5, J7.5, U2.7 (MISO), U31.32 (PA6)
MOSI: J4.1, J7.3, U2.6 (MOSI), U31.33 (PA7)
unnamed: C1.1, Q1.1 (G), R1.2, R4.1
unnamed: C10.1, Q2.1 (G), R2.1, R5.2
unnamed: D1.4 (DI), D2.1 (DO)
unnamed: D2.4 (DI), D3.1 (DO)
unnamed: D3.4 (DI), R6.2
unnamed: J1.2, P1.A4 (VBUS), P1.A9 (VBUS), P1.B4 (VBUS), P1.B9 (VBUS)
unnamed: P1.A5 (CC), R3.1
unnamed: P1.A6 (D+), U31.9 (PA12)
unnamed: P1.A7 (D-), U31.8 (PA11)
unnamed: R1.1, U31.3 (PB14)
unnamed: R5.1, U31.4 (PB15)
unnamed: U4.4 (AIN0), U9.3 (OUT)
unnamed: U4.5 (AIN1), U8.3 (OUT)
unnamed: U4.6 (AIN2), U7.3 (OUT)
unnamed: U4.7 (AIN3), U6.3 (OUT)
unnamed: U10.4 (AIN0), U14.3 (OUT)
unnamed: U10.5 (AIN1), U13.3 (OUT)
unnamed: U10.6 (AIN2), U12.3 (OUT)
unnamed: U10.7 (AIN3), U11.3 (OUT)
unnamed: U15.4 (AIN0), U19.3 (OUT)
unnamed: U15.5 (AIN1), U18.3 (OUT)
unnamed: U15.6 (AIN2), U17.3 (OUT)
unnamed: U15.7 (AIN3), U16.3 (OUT)
unnamed: U20.4 (AIN0), U29.3 (OUT)
unnamed: U20.5 (AIN1), U28.3 (OUT)
unnamed: U20.6 (AIN2), U27.3 (OUT)
unnamed: U20.7 (AIN3), U26.3 (OUT)
unnamed: U21.3 (OUT), U25.7 (AIN3)
unnamed: U22.3 (OUT), U25.6 (AIN2)
unnamed: U23.3 (OUT), U25.5 (AIN1)
unnamed: U24.3 (OUT), U25.4 (AIN0)
SCK: J4.7, J7.7, U2.5 (SCK), U31.31 (PA5)
WAKE_BUTTON: J2.9, J5.9, U31.17 (PB9)

Notes on the sheet:
Addr=SCL
I2C3
ADS1115 breakboard
I2C1
Addr=GND
Plaque NRF
Addr=VCC
Top view
PB14
Plaque Uc
Cache
PB15
Addr=SDA
To NRF module
