javierfileiv/gaspetto/kicad/prototipo-stm32-nrf24l01/prototipo_gaspetto_car.kicad_sch

## KiCad design kicad/prototipo-stm32-nrf24l01/prototipo_gaspetto_car.kicad_sch (2026-04-30)

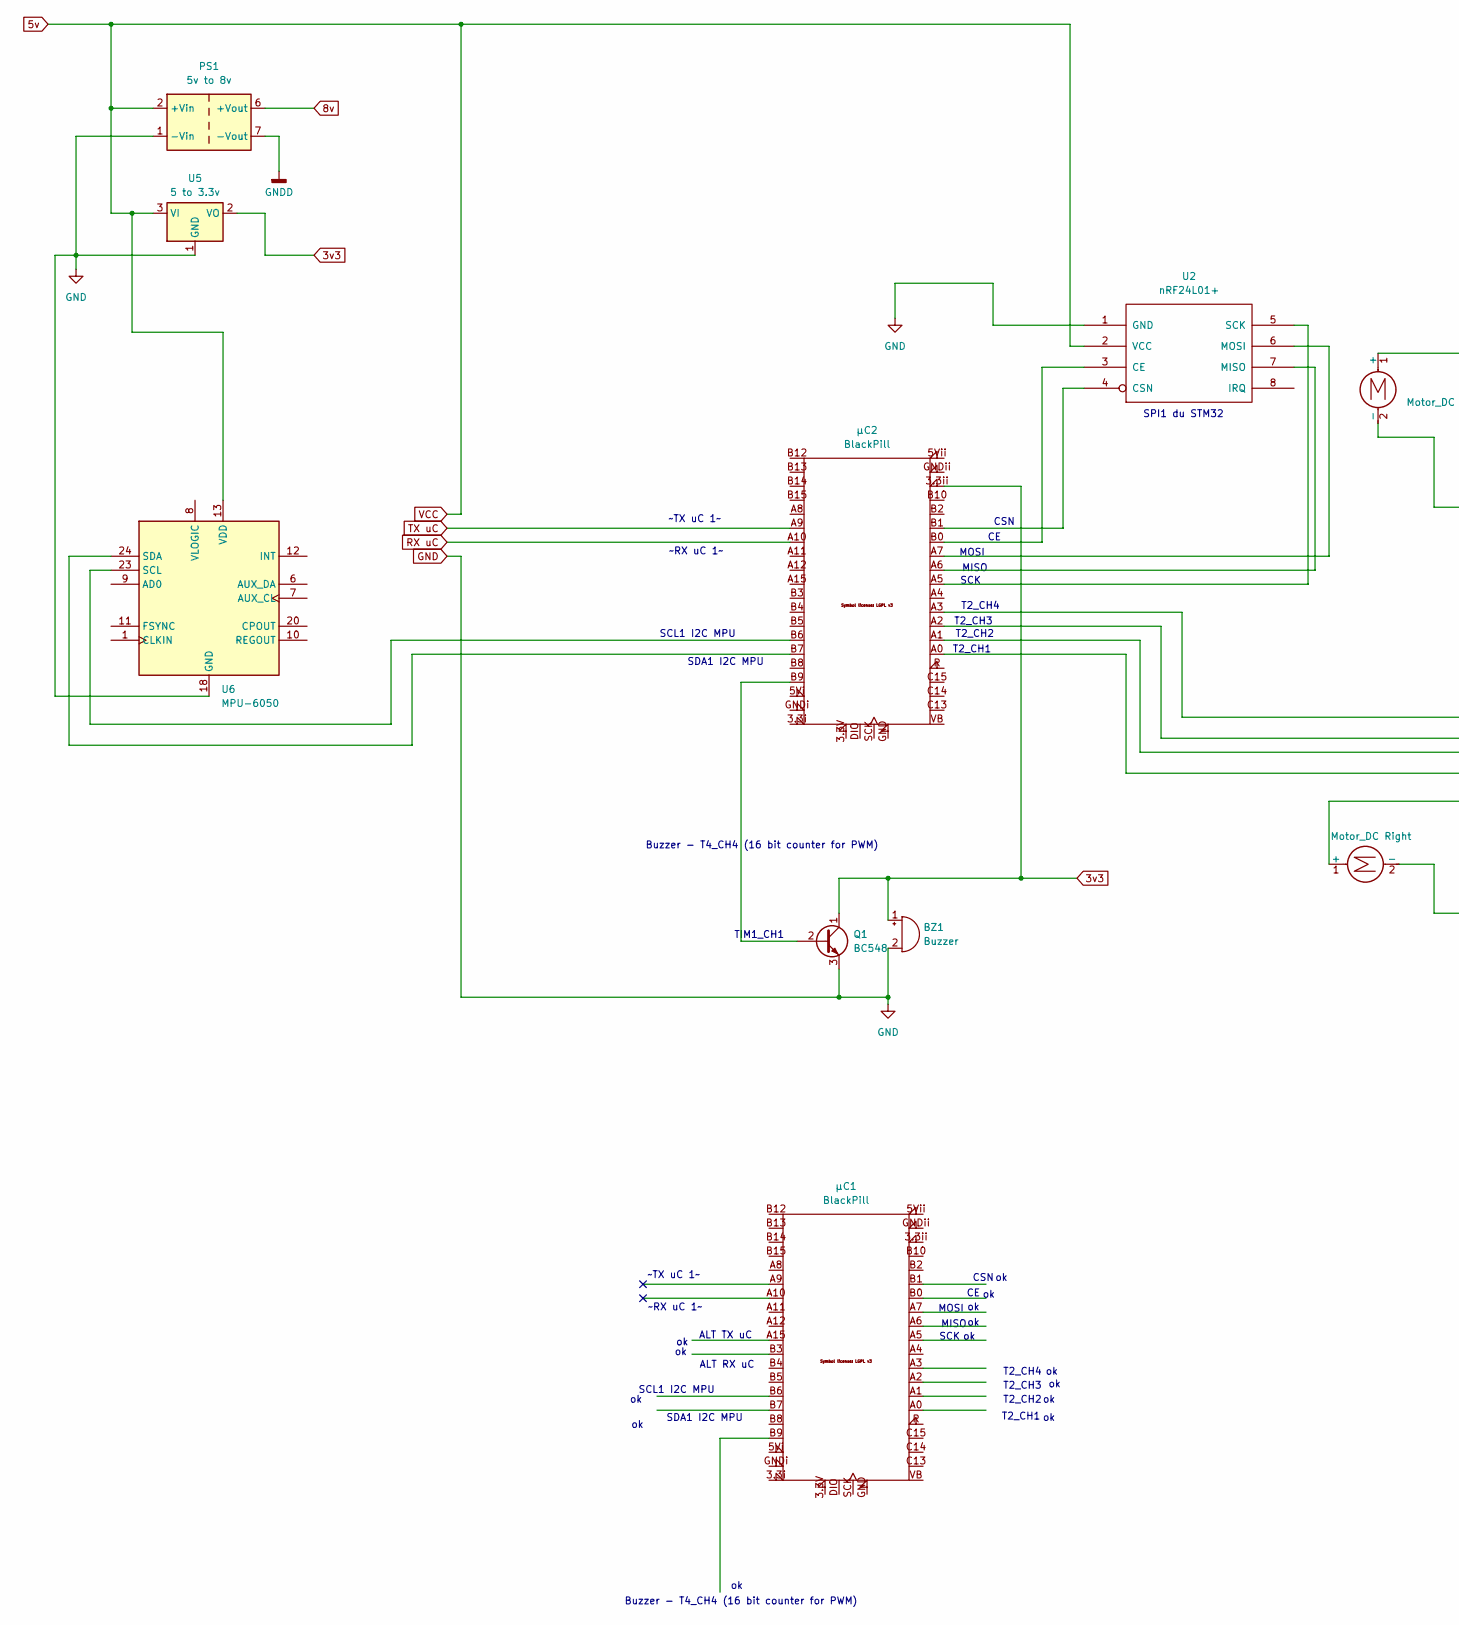
[picture p31: schematic prototipo_gaspetto_car.kicad_sch, part in row 1, column 1]

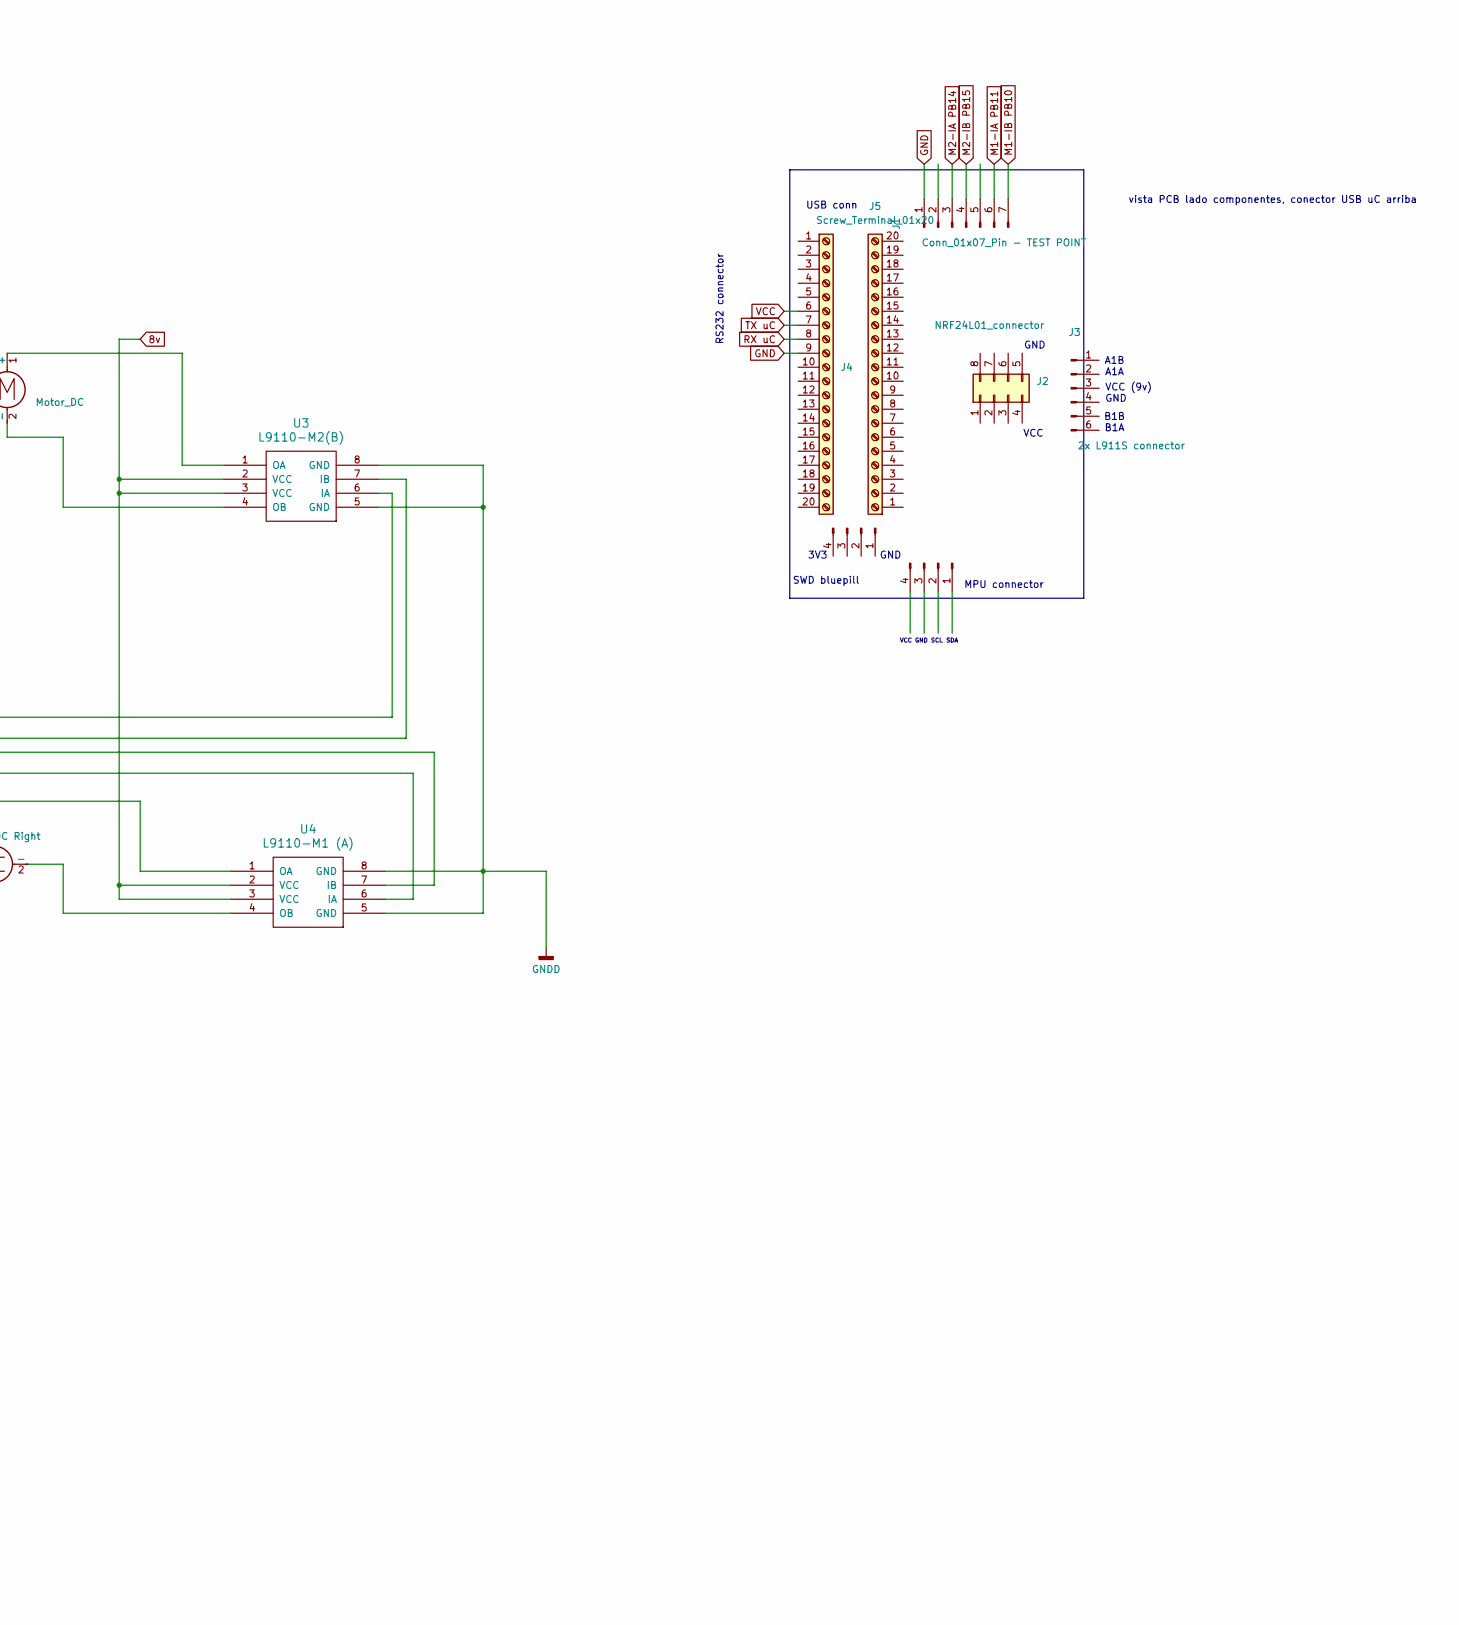
[picture p32: schematic prototipo_gaspetto_car.kicad_sch, part in row 1, column 2]

Parts:
BZ1: Buzzer
J1: Conn_01x07_Pin - TEST POINT
J2: NRF24L01_connector
J3: 2x L911S connector
J4, J5: Screw_Terminal_01x20
J6: Conn_01x04_Pin
M1: Motor_DC Right
M2: Motor_DC
MPU-6050: (no value)
PS1: 5v to 8v; Converter_DCDC_XP_POWER-ITXxxxxSA_THT
Q1: BC548; TO-92_Inline
U2: nRF24L01+; MODULE
U3: L9110-M2(B)
U4: L9110-M1 (A)
U5: 5 to 3.3v; SOT-223-3_TabPin2
U6: MPU-6050; InvenSense_QFN-24_4x4mm_P0.5mm
μC1, μC2: BlackPill

Connections:
3v3: BZ1.1 (+), Q1.1 (C), U5.2 (VO), μC2.3.3ii
5v: J4.6, PS1.2 (+Vin), U2.2 (VCC), U5.3 (VI), U6.13 (VDD)
8v: PS1.6 (+Vout), U3.2 (VCC), U3.3 (VCC), U4.2 (VCC), U4.3 (VCC)
GND: BZ1.2 (-), J1.1, J4.9, PS1.1 (-Vin), Q1.3 (E), U2.1 (GND), U5.1 (GND), U6.18 (GND)
GNDD: PS1.7 (-Vout), U3.5 (GND), U3.8 (GND), U4.5 (GND), U4.8 (GND)
M1-IA PB11: J1.6
M1-IB PB10: J1.7
M2-IA PB14: J1.3
M2-IB PB15: J1.4
unnamed: M1.1 (+), U4.1 (OA)
unnamed: M1.2 (-), U4.4 (OB)
unnamed: M2.1 (+), U3.1 (OA)
unnamed: M2.2 (-), U3.4 (OB)
unnamed: Q1.2 (B), μC2.B9
unnamed: U2.3 (CE), μC2.B0
unnamed: U2.4 (CSN), μC2.B1
unnamed: U2.5 (SCK), μC2.A5
unnamed: U2.6 (MOSI), μC2.A7
unnamed: U2.7 (MISO), μC2.A6
unnamed: U3.6 (IA), μC2.A3
unnamed: U3.7 (IB), μC2.A2
unnamed: U4.6 (IA), μC2.A0
unnamed: U4.7 (IB), μC2.A1
unnamed: U6.23 (SCL), μC2.B6
unnamed: U6.24 (SDA), μC2.B7
RX uC: J4.8, μC2.A10
TX uC: J4.7, μC2.A9

Notes on the sheet:
GND
T2_CH1
SCK
T2_CH4
MOSI
SDA1 I2C MPU
MISO
SCL1 I2C MPU
3V3
~RX uC 1~
A1B A1A
USB conn
RS232 connector
VCC (9v) GND
T2_CH2
SDA
~TX uC 1~
T2_CH3
Buzzer - T4_CH4 (16 bit counter for PWM)
VCC
SWD bluepill
CSN
MPU connector
TIM1_CH1
SCL
vista PCB lado componentes, conector USB uC arriba
B1B B1A
ALT RX uC
ALT TX uC
SPI1 du STM32
