javierfileiv/gaspetto/soft/emu-pc/gaspetto_car/main.cpp

#include "Arduino.h"
#include "EventQueue.h"
#include "GaspettoCar.h"
#include "IdleState.h"
#include "MotorController.h"
#include "ProcessingState.h"
#include "RadioController.h"
#include "TimeredEventQueue.h"

#include <cstdint>

const int NRF_IRQ_PIN = PB0;
const int MOTOR_RIGHT_PIN_A = PB0; /* PWM pin for motor right. */
const int MOTOR_RIGHT_PIN_B = PB1; /* Direction pin for motor right. */
const int MOTOR_LEFT_PIN_A = PB11; /* Example PWM pin for motor left.  */
const int MOTOR_LEFT_PIN_B = PB10; /* Direction pin for motor left.  */
const int SPEED_SENSOR_LEFT_PIN = PA0; /* Pin for left speed/distance sensor. */
const int SPEED_SENSOR_RIGHT_PIN = PA1; /* Pin for right speed/distance sensor. */

IdleState idleState;
ProcessingState processingState;
EventQueue eventQueue;
TimeredEventQueue timeredEventQueue;
MotorController &motorController = MotorController::getInstance();
GaspettoCar gaspetto_car(&idleState, &processingState, &eventQueue, StateId::IDLE,
                         &motorController);

#ifndef ARDUINO
void enqueue_random_commands(const uint8_t num_events)
{
    srand(std::time(nullptr));

    for (uint8_t i = 0; i < num_events; ++i) {
        const CommandId command =
                static_cast<CommandId>(rand() % static_cast<uint8_t>(CommandId::MAX_COMMAND_ID));
        const Event event(EventId::NRF_IRQ, command); /* Random event*/
        gaspetto_car.postEvent(event);
    }
}
#endif

void ISR(void)
{
#ifndef ARDUINO
    Event evt = getEvent();
    gaspetto_car.postEvent(evt);
#endif
}

void setup()
{
    Serial.begin(115200);
    Serial.println("Gaspetto Car Initialized");
    Serial.println("Starting up...\n");
    /* Initialize the GaspettoCar state machine. */
    gaspetto_car.Init();
    /* Initialize the motor controller. */
    motorController.setPins(MOTOR_LEFT_PIN_A, MOTOR_LEFT_PIN_B, MOTOR_RIGHT_PIN_A,
                            MOTOR_RIGHT_PIN_B, SPEED_SENSOR_LEFT_PIN, SPEED_SENSOR_RIGHT_PIN);
#ifdef NRF_IRQ
    /* Set up ISR for NRF IRQ. */
    attachInterrupt(digitalPinToInterrupt(NRF_IRQ_PIN), ISR, RISING);
#else
    timeredEventQueue.scheduleEventDelayed(1000, Event(EventId::NRF_IRQ, CommandId::MOTOR_FORWARD));
    timeredEventQueue.scheduleEventDelayed(4000,
                                           Event(EventId::NRF_IRQ, CommandId::MOTOR_BACKWARD));
    timeredEventQueue.scheduleEventDelayed(10000, Event(EventId::NRF_IRQ, CommandId::MOTOR_RIGHT));
    timeredEventQueue.scheduleEventDelayed(6000, Event(EventId::NRF_IRQ, CommandId::MOTOR_STOP));
    timeredEventQueue.scheduleEventDelayed(2000, Event(EventId::NRF_IRQ, CommandId::MOTOR_LEFT));
    timeredEventQueue.scheduleEventDelayed(17000, Event(EventId::NRF_IRQ, CommandId::MOTOR_STOP));
#endif
}

void loop()
{
    //     radioController.process_radio();
    gaspetto_car.processNextEvent();
    timeredEventQueue.processEvents(gaspetto_car);
}
