javierfileiv/gaspetto/soft/emu-pc/targets/gcar/include/IdleState.h

#pragma once

#include "Events.h"
#include "State.h"

/**
 * @brief Idle state for GCar.
 *
 * Enters low power mode and waits for motor commands.
 */
class IdleState : public GenericState<Event> {
public:
    void enter() override;
    void processEvent(Event &evt) override;
};
