javierfileiv/gaspetto/soft/emu-pc/targets/gcar/include/ProcessingState.h

#pragma once

#include "Events.h"
#include "State.h"

/**
 * @brief Processing state for GCar.
 *
 * Handles motor commands and transitions back to idle on stop.
 */
class ProcessingState : public GenericState<Event> {
public:
    void processEvent(Event &evt) override;
};
