javierfileiv/gaspetto/soft/emu-pc/targets/gcar/movement_controller/include/MotorControlInterface.h

#pragma once

#include <stdint.h>

enum MotorSide { LEFT, RIGHT, MAX_SIDES };
enum PinPerSide { BWD, FWD, MAX_PIN };

class MotorControlInterface {
public:
    virtual ~MotorControlInterface() = default;

    virtual void init(uint32_t pwm_freq) = 0;
    virtual void setMotorSpeeds(uint32_t leftSpeed, uint32_t rightSpeed, bool leftForward,
                                bool rightForward) = 0;
    virtual void setPWMfrequency(uint32_t frequency) = 0;
    virtual void setPWMdutyCycle(MotorSide side, PinPerSide pin, uint32_t duty) = 0;
    virtual void stopBothMotors() = 0;
};
