javierfileiv/gaspetto/soft/emu-pc/targets/gbox/src/ProcessingState.cpp

#include "ProcessingState.h"

#include "GBox.h"

void ProcessingState::enter()
{
    GBox *box = static_cast<GBox *>(active_object_);
    CommandPacket packet{};
    bool isEmpty = false;

    box->restoreFromStop();
    box->setSensorRailEnabled(true);
    box->runScanAnimation();
    box->scanSlots();

    const bool programReady = box->buildProgram(packet, isEmpty);
    box->setSensorRailEnabled(false);

    if (!programReady) {
        if (isEmpty) {
            box->runEmptyBoardAnimation();
        } else {
            box->runBuildErrorAnimation();
        }
        box->transitionTo(StateId::IDLE);
        return;
    }

    const bool radioOk = box->sendProgram(packet);
    if (radioOk) {
        box->runSuccessAnimation();
    } else {
        box->runRfErrorAnimation();
    }

    box->transitionTo(StateId::IDLE);
}

void ProcessingState::processEvent(Event &evt)
{
    GBox *box = static_cast<GBox *>(active_object_);

    switch (evt.getEventId()) {
    case EventId::BUTTON_PRESSED:
        /* Button pressed during processing - interrupt and send clear queue command */
        box->interruptScanning();
        box->sendClearQueueCommand();
        box->transitionTo(StateId::IDLE);
        break;
    default:
        break;
    }
}
