javierfileiv/gaspetto/soft/emu-pc/targets/gbox/src/GBox.cpp

#include "GBox.h"

#include "ActiveObject.h"
#include "Arduino.h"
#include "CommandPacket.h"
#include "Context.h"
#include "Events.h"
#include "RadioController.h"
#include "piece_thresholds.h"
#include "pin_definitions.h"

#include <Adafruit_ADS1X15.h>
#include <array>
#include <cstdint>
#ifdef ARDUINO
#include "BitBangWire.h"
#include "i2c3_bitbang.h"
#include "stm32f4xx_hal.h"

#include <Adafruit_NeoPixel.h>
#endif
#include <Wire.h>

namespace
{
#ifndef GASPETTO_I2C_CLOCK_HZ
#define GASPETTO_I2C_CLOCK_HZ 100000
#endif

#ifndef GASPETTO_ADC_SAMPLES_PER_CHANNEL
#define GASPETTO_ADC_SAMPLES_PER_CHANNEL 3
#endif

#ifndef GASPETTO_ADC_MIN_VALID_SAMPLES
#define GASPETTO_ADC_MIN_VALID_SAMPLES 2
#endif

#ifndef GASPETTO_ADC_READ_RECOVERY_RETRIES
#define GASPETTO_ADC_READ_RECOVERY_RETRIES 1
#endif

#ifndef GASPETTO_ADC_CONVERSION_TIMEOUT_MS
#define GASPETTO_ADC_CONVERSION_TIMEOUT_MS 40
#endif

/* Piece thresholds come from the shared piece_thresholds.h, with their
 * static asserts. Only sampling and timing knobs stay defined here */

static_assert(GASPETTO_ADC_SAMPLES_PER_CHANNEL > 0,
              "GASPETTO_ADC_SAMPLES_PER_CHANNEL must be >= 1");
static_assert(GASPETTO_ADC_MIN_VALID_SAMPLES > 0, "GASPETTO_ADC_MIN_VALID_SAMPLES must be >= 1");
static_assert(GASPETTO_ADC_MIN_VALID_SAMPLES <= GASPETTO_ADC_SAMPLES_PER_CHANNEL,
              "GASPETTO_ADC_MIN_VALID_SAMPLES must be <= GASPETTO_ADC_SAMPLES_PER_CHANNEL");

constexpr std::array<AdcDecodeEntry, 6> kAdcDecodeTable = {
    AdcDecodeEntry{ 0, static_cast<uint16_t>(GASPETTO_ADC_THRESHOLD_FORWARD_START - 1),
                    BoxPieceId::EMPTY, "EMPTY" },
    AdcDecodeEntry{ GASPETTO_ADC_THRESHOLD_FORWARD_START,
                    static_cast<uint16_t>(GASPETTO_ADC_THRESHOLD_BACKWARD_START - 1),
                    BoxPieceId::FORWARD, "FORWARD" },
    AdcDecodeEntry{ GASPETTO_ADC_THRESHOLD_BACKWARD_START,
                    static_cast<uint16_t>(GASPETTO_ADC_THRESHOLD_TURN_RIGHT_START - 1),
                    BoxPieceId::BACKWARD, "BACKWARD" },
    AdcDecodeEntry{ GASPETTO_ADC_THRESHOLD_TURN_RIGHT_START,
                    static_cast<uint16_t>(GASPETTO_ADC_THRESHOLD_TURN_LEFT_START - 1),
                    BoxPieceId::TURN_RIGHT, "TURN_RIGHT" },
    AdcDecodeEntry{ GASPETTO_ADC_THRESHOLD_TURN_LEFT_START,
                    static_cast<uint16_t>(GASPETTO_ADC_THRESHOLD_LOOP_START - 1),
                    BoxPieceId::TURN_LEFT, "TURN_LEFT" },
    AdcDecodeEntry{ GASPETTO_ADC_THRESHOLD_LOOP_START, GASPETTO_ADC_THRESHOLD_LOOP_END,
                    BoxPieceId::LOOP_CALL, "LOOP_CALL" },
};

constexpr uint8_t kChannelsPerAds = 4;
constexpr uint32_t kI2cClockHz = GASPETTO_I2C_CLOCK_HZ;
constexpr uint8_t kAdcSamplesPerChannel = GASPETTO_ADC_SAMPLES_PER_CHANNEL;
constexpr uint8_t kAdcMinValidSamples = GASPETTO_ADC_MIN_VALID_SAMPLES;
constexpr uint8_t kAdcReadRecoveryRetries = GASPETTO_ADC_READ_RECOVERY_RETRIES;
constexpr uint16_t kAdcConversionTimeoutMs = GASPETTO_ADC_CONVERSION_TIMEOUT_MS;

constexpr std::array<uint16_t, 4> kMuxByChannel = {
    ADS1X15_REG_CONFIG_MUX_SINGLE_0,
    ADS1X15_REG_CONFIG_MUX_SINGLE_1,
    ADS1X15_REG_CONFIG_MUX_SINGLE_2,
    ADS1X15_REG_CONFIG_MUX_SINGLE_3,
};

enum class AdsBus : uint8_t {
    BUS_1,
    BUS_3,
};

struct AdsDeviceConfig {
    AdsBus bus;
    uint8_t address;
    uint8_t slotBase;
};

#ifdef ARDUINO
BitBangWire gI2c3(I2C3_SDA_PIN, I2C3_SCL_PIN);
#else
TwoWire gI2c3;
#endif

constexpr std::array<AdsDeviceConfig, 5> kAdsDevices = {
    AdsDeviceConfig{ AdsBus::BUS_1, 0x48, 0 },  AdsDeviceConfig{ AdsBus::BUS_1, 0x49, 4 },
    AdsDeviceConfig{ AdsBus::BUS_1, 0x4A, 8 },  AdsDeviceConfig{ AdsBus::BUS_1, 0x4B, 12 },
    AdsDeviceConfig{ AdsBus::BUS_3, 0x4A, 16 },
};

#ifdef ARDUINO
/* Expected LED behaviour, three NeoPixels on the strip, left to right:
 * - boot health check: led 0 (left) lights solid green when every probe passes,
 *   solid red otherwise, holds ~1.5s then goes off
 * - board scan: a cyan dot bounces led 0 -> 1 -> 2 -> back twice, then blackout
 * - program accepted: green cascades led 0 -> 1 -> 2, all three hold green
 * - build failed: led 2 (right) blinks red three times, then holds red
 * - empty board: led 2 blinks amber twice, then holds amber
 * - RF send failed: led 1 (center) blinks red three times, then holds with led
 *   1 red plus led 0 green
 * Terminal states hold their pattern ~60s, then the box arms STOP mode and all
 * LEDs go off (PC emulation runs the same patterns as log-only animations)
 */
constexpr uint8_t kLedState = 0; /* left   : system / scan state   */
constexpr uint8_t kLedRadio = 1; /* center : radio status           */
constexpr uint8_t kLedBuild = 2; /* right  : build / program error  */
#endif

TwoWire &wireForAdsBus(AdsBus bus)
{
    return bus == AdsBus::BUS_1 ? Wire : gI2c3;
}

void recoverAdsBus(AdsBus bus)
{
    TwoWire &wire = wireForAdsBus(bus);

    wire.end();
    delay(5);

    if (bus == AdsBus::BUS_1) {
        Wire.setSCL(I2C1_SCL_PIN);
        Wire.setSDA(I2C1_SDA_PIN);
    } else {
        gI2c3.setSCL(I2C3_SCL_PIN);
        gI2c3.setSDA(I2C3_SDA_PIN);
    }

    wire.begin();
    wire.setClock(kI2cClockHz);
    delay(10);
}

bool readSingleEndedWithTimeout(Adafruit_ADS1115 &ads, uint8_t channel, int16_t &raw)
{
    if (channel >= kMuxByChannel.size()) {
        return false;
    }

    ads.startADCReading(kMuxByChannel[channel], false);
    const unsigned long startMs = millis();
    while (!ads.conversionComplete()) {
        if (millis() - startMs > kAdcConversionTimeoutMs) {
            return false;
        }
        delay(1);
    }

    raw = ads.getLastConversionResults();
    return true;
}

const char *busName(AdsBus bus)
{
    return bus == AdsBus::BUS_1 ? "I2C1" : "I2C3";
}

CommandId pieceToCommand(BoxPieceId piece)
{
    switch (piece) {
    case BoxPieceId::FORWARD:
        return CommandId::MOTOR_FORWARD;
    case BoxPieceId::BACKWARD:
        return CommandId::MOTOR_BACKWARD;
    case BoxPieceId::TURN_RIGHT:
        return CommandId::MOTOR_TURN_RIGHT;
    case BoxPieceId::TURN_LEFT:
        return CommandId::MOTOR_TURN_LEFT;
    default:
        return CommandId::NONE;
    }
}

bool appendCommand(CommandPacket &packet, CommandId command)
{
    if (packet.count >= BOX_MAX_PAYLOAD_COMMANDS) {
        return false;
    }

    packet.commands[packet.count] = static_cast<uint8_t>(command);
    ++packet.count;
    return true;
}

bool appendPieceCommand(CommandPacket &packet, BoxPieceId piece)
{
    const CommandId command = pieceToCommand(piece);

    if (command == CommandId::NONE) {
        return piece == BoxPieceId::EMPTY;
    }

    return appendCommand(packet, command);
}
}

GBox::GBox(Context &ctx)
        : GenericActiveObject()
        , _ctx(ctx)
        , lastScan{}
#ifdef ARDUINO
        , leds_(BOX_LED_COUNT, PIN_LED_DATA, NEO_GRB + NEO_KHZ800)
#endif
        , initialized_(false)
        , lastDebounceTime_(0)
        , isScanning_(false)
{
    initMachine(StateId::IDLE, ctx.idleState);
    initMachine(StateId::PROCESSING, ctx.processingState);
}

void GBox::init(StateId initialStateId)
{
    GenericActiveObject::init(initialStateId);
}

int GBox::postEvent(Event evt)
{
    if (_ctx.mainEventQueue) {
        _ctx.mainEventQueue->enqueue(evt);
        return 0;
    }
    return -1;
}

void GBox::work()
{
    if (_ctx.mainEventQueue && !_ctx.mainEventQueue->IsEmpty()) {
        Event evt;

        StateType *currentState = states[static_cast<uint8_t>(currentStateIndex)];
        _ctx.mainEventQueue->dequeue(evt);
        currentState->processEvent(evt);
    }
}

void GBox::enterLowPowerMode()
{
    prepareForStop();
#ifdef LOW_POWER_MODE
#ifndef ARDUINO
    LOGLN("Entering low-power mode...\n");
    if (lowPowerCallback_) {
        lowPowerCallback_();
    }
#else
    HAL_SuspendTick();
    HAL_PWR_EnterSTOPMode(PWR_LOWPOWERREGULATOR_ON, PWR_STOPENTRY_WFI);
    HAL_ResumeTick();
    restoreFromStop();
#endif
#endif
}

void GBox::debounceAndEnqueue(Event &evt, unsigned long currentTime)
{
#ifdef ARDUINO
    if (currentTime - lastDebounceTime_ > debounceDelay) {
        lastDebounceTime_ = currentTime;
        if (!_ctx.mainEventQueue->IsFull()) {
            _ctx.mainEventQueue->enqueue(evt);
            LOGLN("Exiting low-power mode...\n");
        } else {
            LOGLN("Event queue is full! Unable to enqueue event.\n");
        }
    }
#else
    if (!_ctx.mainEventQueue->IsFull()) {
        postEvent(evt);
    } else {
        LOGLN("Event queue is full! Unable to enqueue event.\n");
    }
#endif
}

bool GBox::buildProgramFromPieces(const BoxBoardPieces &boardPieces, CommandPacket &packet,
                                  bool &isEmpty)
{
    std::array<BoxPieceId, BOX_LOOP_SLOTS> loopPieces = {};

    packet.count = 0;
    for (std::size_t index = 0; index < BOX_MAX_PAYLOAD_COMMANDS; ++index) {
        packet.commands[index] = static_cast<uint8_t>(CommandId::NONE);
    }

    for (std::size_t slot = 0; slot < BOX_LOOP_SLOTS; ++slot) {
        loopPieces[slot] = boardPieces[BOX_MAIN_SLOTS + slot];
        if (loopPieces[slot] == BoxPieceId::INVALID) {
            isEmpty = false;
            return false;
        }
        if (loopPieces[slot] == BoxPieceId::LOOP_CALL) {
            loopPieces[slot] = BoxPieceId::EMPTY;
        }
    }

    for (std::size_t slot = 0; slot < BOX_MAIN_SLOTS; ++slot) {
        const BoxPieceId piece = boardPieces[slot];

        if (piece == BoxPieceId::EMPTY) {
            continue;
        }

        if (piece == BoxPieceId::INVALID) {
            isEmpty = false;
            return false;
        }

        if (piece == BoxPieceId::LOOP_CALL) {
            for (std::size_t loopSlot = 0; loopSlot < BOX_LOOP_SLOTS; ++loopSlot) {
                if (loopPieces[loopSlot] == BoxPieceId::EMPTY) {
                    continue;
                }

                if (!appendPieceCommand(packet, loopPieces[loopSlot])) {
                    isEmpty = false;
                    return false;
                }
            }
            continue;
        }

        if (!appendPieceCommand(packet, piece)) {
            isEmpty = false;
            return false;
        }
    }

    isEmpty = packet.count == 0;
    return !isEmpty;
}

bool GBox::routeForSlot(std::size_t slot, AdsRouteInfo &route)
{
    for (const AdsDeviceConfig &device : kAdsDevices) {
        const std::size_t slotBase = static_cast<std::size_t>(device.slotBase);
        const std::size_t slotEnd = slotBase + kChannelsPerAds;
        if (slot >= slotBase && slot < slotEnd) {
            route.usesI2c3 = device.bus == AdsBus::BUS_3;
            route.address = device.address;
            route.channel = static_cast<uint8_t>(slot - slotBase);
            return true;
        }
    }

    return false;
}

void GBox::initHardware()
{
    if (initialized_) {
        return;
    }

    configurePins();
    Wire.setSCL(I2C1_SCL_PIN);
    Wire.setSDA(I2C1_SDA_PIN);
    Wire.begin();

    gI2c3.setSCL(I2C3_SCL_PIN);
    gI2c3.setSDA(I2C3_SDA_PIN);
    gI2c3.begin();

#ifdef ARDUINO
    leds_.begin();
    leds_.clear();
    leds_.show();
#endif

    if (_ctx.radioController != nullptr) {
        _ctx.radioController->init();
    }
    initialized_ = true;
    LOGLN("GBox: hardware initialized.");
}

bool GBox::runHealthCheck()
{
#ifdef ARDUINO
    bool allOk = true;

    /* Power up the ADS1115 modules on the 3V3 rail before probing. */
    setSensorRailEnabled(true);
    delay(100); /* Let the rail settle. */

    LOGLN("--- Hardware health check ---");

    /* Probe I2C1: 4 ADS1115 addresses (0x48-0x4B). */
    constexpr uint8_t kI2c1Addresses[] = { 0x48, 0x49, 0x4A, 0x4B };
    for (uint8_t addr : kI2c1Addresses) {
        Wire.beginTransmission(addr);
        bool ack = (Wire.endTransmission() == 0);
        LOG("I2C1 0x");
        LOG(addr, HEX);
        LOG(": ");
        LOGLN(ack ? "[OK]" : "[FAIL]");
        if (!ack)
            allOk = false;
    }

    /* Probe I2C3: 1 ADS1115 via bit-bang. */
    bool i2c3Ok = i2c3_bb_probe(0x4A);
    LOG("I2C3 0x4A: ");
    LOGLN(i2c3Ok ? "[OK]" : "[FAIL]");
    if (!i2c3Ok)
        allOk = false;

    /* Check radio. */
    bool radioOk = false;
    if (_ctx.radioController != nullptr) {
        radioOk = _ctx.radioController->isChipConnected();
    }
    LOG("nRF24: ");
    LOGLN(radioOk ? "[OK]" : "[FAIL]");
    if (!radioOk)
        allOk = false;

    LOGLN("--- Check complete ---");

    showHealthStatus(allOk);
    setSensorRailEnabled(false);
    return allOk;
#else
    return true;
#endif
}

void GBox::showHealthStatus(bool ok)
{
#ifdef ARDUINO
    if (ok) {
        leds_.setPixelColor(0, leds_.Color(0, 50, 0)); /* Green. */
    } else {
        leds_.setPixelColor(0, leds_.Color(50, 0, 0)); /* Red. */
    }
    leds_.show();
    delay(1500);
    leds_.setPixelColor(0, 0);
    leds_.show();
#endif
}

#ifndef ARDUINO
/* Used for command injection in emulation mode. */
void GBox::injectBoardPieces(const BoxBoardPieces &boardPieces)
{
    for (std::size_t index = 0; index < BOX_TOTAL_SLOTS; ++index) {
        Adafruit_ADS1115::setRawValue(index,
                                      static_cast<int16_t>(rawValueForPiece(boardPieces[index])));
    }
    LOGLN("GBox: board pieces injected.");
}

/* Used for command injection in emulation mode. */
void GBox::injectRawAdcValues(const std::array<uint16_t, BOX_TOTAL_SLOTS> &rawValues)
{
    for (std::size_t index = 0; index < BOX_TOTAL_SLOTS; ++index) {
        Adafruit_ADS1115::setRawValue(index, static_cast<int16_t>(rawValues[index]));
    }
    LOGLN("GBox: raw ADC values injected.");
}
#endif

void GBox::restoreFromStop()
{
    SystemClock_Config();
    LOGLN("GBox: wake-up sequence complete.");
}

void GBox::SystemClock_Config()
{
#ifdef ARDUINO
    /* STM32 clocks must be restored here after STOP wake-up on target hardware. */
#else
    LOGLN("SystemClock_Config(): emulated clock tree restored after STOP.");
#endif
}

void GBox::configurePins()
{
    pinMode(PIN_MOSFET_5V_LEDS, OUTPUT_OPEN_DRAIN);
    digitalWrite(PIN_MOSFET_5V_LEDS, HIGH);

    pinMode(PIN_MOSFET_3V3_SENSORS, OUTPUT);
    digitalWrite(PIN_MOSFET_3V3_SENSORS, HIGH);

    pinMode(PIN_LED_DATA, OUTPUT);
    digitalWrite(PIN_LED_DATA, LOW);

    pinMode(PIN_WAKE_BUTTON, INPUT_PULLUP);
}

void GBox::setSensorRailEnabled(bool enabled)
{
    digitalWrite(PIN_MOSFET_3V3_SENSORS, enabled ? LOW : HIGH);
    LOG(enabled ? "3.3V sensor rail ON" : "3.3V sensor rail OFF");
    LOGLN();
}

void GBox::setLedRailEnabled(bool enabled)
{
    digitalWrite(PIN_MOSFET_5V_LEDS, enabled ? LOW : HIGH);
    LOG(enabled ? "5V LED rail ON (PB14 pulled low)" : "5V LED rail OFF (PB14 released)");
    LOGLN();
}

void GBox::blackoutLeds()
{
#ifdef ARDUINO
    leds_.clear();
    leds_.show();
#endif
    LOGLN("LEDs: blackout.");
}

void GBox::delayMs(int ms) const
{
    delay(ms);
}

void GBox::runScanAnimation()
{
    setLedRailEnabled(true);
    delayMs(50);

#ifdef ARDUINO
    /* Bouncing cyan on kLedState → kLedRadio → kLedBuild → back, 2 round trips. */
    for (int trip = 0; trip < 2; ++trip) {
        for (int i = 0; i < 3; ++i) {
            leds_.clear();
            leds_.setPixelColor(static_cast<uint16_t>(i), leds_.Color(0, 80, 80));
            leds_.show();
            delayMs(120);
        }
        for (int i = 1; i >= 0; --i) {
            leds_.clear();
            leds_.setPixelColor(static_cast<uint16_t>(i), leds_.Color(0, 80, 80));
            leds_.show();
            delayMs(120);
        }
    }
    blackoutLeds();
#else
    for (std::size_t led = 0; led < BOX_LED_COUNT; ++led) {
        LOG("LED scanner CYAN led (Scan animation) ");
        LOG(static_cast<int>(led) + 1);
        LOGLN();
        delayMs(15);
    }
#endif
}

void GBox::runSuccessAnimation()
{
    setLedRailEnabled(true);
#ifdef ARDUINO
    /* Cascade green: LED0 → LED1 → LED2, then hold all solid green ~1min. */
    leds_.clear();
    for (int i = 0; i < 3; ++i) {
        leds_.setPixelColor(static_cast<uint16_t>(i), leds_.Color(0, 100, 0));
        leds_.show();
        delayMs(150);
    }
    delayMs(60000); /* Hold result visible ~1min before STOP. */
#else
    for (int pulse = 0; pulse < 3; ++pulse) {
        LOG("LED pulse GREEN step (Success animation) ");
        LOG(pulse + 1);
        LOGLN();
        delayMs(70);
    }
    blackoutLeds();
    setLedRailEnabled(false);
#endif
}

void GBox::runBuildErrorAnimation()
{
    setLedRailEnabled(true);
#ifdef ARDUINO
    /* kLedBuild (right) blinks red ×3, then holds red on kLedBuild. */
    for (int blink = 0; blink < 3; ++blink) {
        leds_.clear();
        leds_.setPixelColor(kLedBuild, leds_.Color(150, 0, 0));
        leds_.show();
        delayMs(90);
        blackoutLeds();
        delayMs(45);
    }
    leds_.setPixelColor(kLedBuild, leds_.Color(150, 0, 0));
    leds_.show();
    delayMs(60000); /* Hold result visible ~1min before STOP. */
#else
    LOGLN("LED build error: LED2 blinks red (Build error animation).");
    for (int blink = 0; blink < 3; ++blink) {
        LOG("LED blink RED (build) step (Build error animation) ");
        LOG(blink + 1);
        LOGLN();
        delayMs(90);
    }
    blackoutLeds();
    setLedRailEnabled(false);
#endif
}

void GBox::runEmptyBoardAnimation()
{
    setLedRailEnabled(true);
#ifdef ARDUINO
    /* kLedBuild (right) blinks amber ×2, then holds amber on kLedBuild. */
    for (int blink = 0; blink < 2; ++blink) {
        leds_.clear();
        leds_.setPixelColor(kLedBuild, leds_.Color(100, 60, 0));
        leds_.show();
        delayMs(200);
        blackoutLeds();
        delayMs(100);
    }
    leds_.setPixelColor(kLedBuild, leds_.Color(100, 60, 0));
    leds_.show();
    delayMs(60000); /* Hold result visible ~1min before STOP. */
#else
    LOGLN("LED empty board: LED2 blinks amber.");
    for (int blink = 0; blink < 2; ++blink) {
        LOG("LED blink AMBER (empty) step ");
        LOG(blink + 1);
        LOGLN();
        delayMs(200);
    }
    blackoutLeds();
    setLedRailEnabled(false);
#endif
}

void GBox::runRfErrorAnimation()
{
    setLedRailEnabled(true);
#ifdef ARDUINO
    /* kLedRadio (center) blinks red ×3, then holds: kLedState green + kLedRadio red. */
    for (int blink = 0; blink < 3; ++blink) {
        leds_.clear();
        leds_.setPixelColor(kLedRadio, leds_.Color(150, 0, 0));
        leds_.show();
        delayMs(90);
        blackoutLeds();
        delayMs(45);
    }
    leds_.setPixelColor(kLedState, leds_.Color(0, 80, 0));
    leds_.setPixelColor(kLedRadio, leds_.Color(150, 0, 0));
    leds_.show();
    delayMs(60000); /* Hold result visible ~1min before STOP. */
#else
    LOGLN("LED radio error: LED1 blinks red.");
    for (int blink = 0; blink < 3; ++blink) {
        LOG("LED blink RED (radio) step ");
        LOG(blink + 1);
        LOGLN();
        delayMs(90);
    }
    blackoutLeds();
    setLedRailEnabled(false);
#endif
}

void GBox::scanSlots()
{
    for (const AdsDeviceConfig &device : kAdsDevices) {
        Adafruit_ADS1115 ads;
        TwoWire &deviceWire = wireForAdsBus(device.bus);

        if (!ads.begin(device.address, &deviceWire)) {
            LOG("ADS init failed [");
            LOG(busName(device.bus));
            LOG(" addr=0x");
            LOG(device.address, HEX);
            LOGLN("]");
            for (uint8_t channel = 0; channel < kChannelsPerAds; ++channel) {
                const std::size_t slot = static_cast<std::size_t>(device.slotBase) + channel;
                lastScan[slot].rawValue = 0;
                lastScan[slot].piece = BoxPieceId::INVALID;
            }
            continue;
        }

        ads.setGain(GAIN_ONE);
        for (uint8_t channel = 0; channel < kChannelsPerAds; ++channel) {
            const std::size_t slot = static_cast<std::size_t>(device.slotBase) + channel;
            bool readOk = false;
            uint16_t rawU16 = 0;
            uint8_t attemptUsed = 0;
            uint8_t bestValidSamples = 0;
            uint8_t timeoutCount = 0;
            uint8_t negativeCount = 0;

            for (uint8_t recoveryAttempt = 0; recoveryAttempt <= kAdcReadRecoveryRetries;
                 ++recoveryAttempt) {
                uint32_t sum = 0;
                uint8_t validSamples = 0;

                for (uint8_t sample = 0; sample < kAdcSamplesPerChannel; ++sample) {
                    int16_t raw = 0;
                    if (!readSingleEndedWithTimeout(ads, channel, raw)) {
                        ++timeoutCount;
                        continue;
                    }

                    if (raw >= 0) {
                        sum += static_cast<uint16_t>(raw);
                        ++validSamples;
                    } else {
                        ++negativeCount;
                    }
                }

                if (validSamples > bestValidSamples) {
                    bestValidSamples = validSamples;
                }

                if (validSamples >= kAdcMinValidSamples) {
                    rawU16 = static_cast<uint16_t>(sum / validSamples);
                    readOk = true;
                    attemptUsed = recoveryAttempt;
                    break;
                }

                if (recoveryAttempt < kAdcReadRecoveryRetries) {
                    LOG("ADC retry [");
                    LOG(busName(device.bus));
                    LOG(" addr=0x");
                    LOG(device.address, HEX);
                    LOG(" ch=");
                    LOG(static_cast<int>(channel));
                    LOG("] valid=");
                    LOG(validSamples);
                    LOG("/");
                    LOG(kAdcSamplesPerChannel);
                    LOG(" timeouts=");
                    LOG(timeoutCount);
                    LOG(" negatives=");
                    LOG(negativeCount);
                    LOGLN();

                    recoverAdsBus(device.bus);
                    if (!ads.begin(device.address, &deviceWire)) {
                        LOG("ADS re-init failed [");
                        LOG(busName(device.bus));
                        LOG(" addr=0x");
                        LOG(device.address, HEX);
                        LOGLN("]");
                        break;
                    }
                    ads.setGain(GAIN_ONE);
                }
            }

            lastScan[slot].rawValue = readOk ? rawU16 : 0;
            lastScan[slot].piece = readOk ? decodePiece(rawU16) : BoxPieceId::INVALID;

            LOG("Scan slot ");
            LOG(static_cast<int>(slot) + 1);
            LOG(" [");
            LOG(busName(device.bus));
            LOG(" addr=0x");
            LOG(device.address, HEX);
            LOG(" ch=");
            LOG(static_cast<int>(channel));
            LOG("]");
            if (readOk) {
                LOG(": ADC(avg)=");
                LOG(lastScan[slot].rawValue);
                LOG(" samples=");
                LOG(bestValidSamples);
                LOG("/");
                LOG(kAdcSamplesPerChannel);
                LOG(" attempt=");
                LOG(attemptUsed + 1);
                LOG(" => ");
                LOGLN(pieceToString(lastScan[slot].piece));
            } else {
                LOG(": ADC read failed valid=");
                LOG(bestValidSamples);
                LOG("/");
                LOG(kAdcSamplesPerChannel);
                LOG(" timeouts=");
                LOG(timeoutCount);
                LOG(" negatives=");
                LOG(negativeCount);
                LOGLN(" => INVALID");
            }
        }
    }
}

bool GBox::buildProgram(CommandPacket &packet, bool &isEmpty)
{
    BoxBoardPieces boardPieces = {};

    for (std::size_t slot = 0; slot < BOX_TOTAL_SLOTS; ++slot) {
        boardPieces[slot] = lastScan[slot].piece;
    }

    const bool built = buildProgramFromPieces(boardPieces, packet, isEmpty);
    if (!built) {
        if (isEmpty) {
            LOGLN("Board scan produced an empty payload.");
        } else {
            LOGLN("Program build failed due to invalid token or payload overflow.");
        }
        return false;
    }

    LOG("Program payload count: ");
    LOG(packet.count);
    LOGLN();
    return true;
}

bool GBox::sendProgram(const CommandPacket &packet)
{
    if (_ctx.radioController == nullptr) {
        LOGLN("Radio controller unavailable.");
        return false;
    }

    LOG("Sending program with ");
    LOG(packet.count);
    LOGLN(" commands.");

    return _ctx.radioController->sendBuffer(&packet, sizeof(packet));
}

void GBox::prepareForStop()
{
    blackoutLeds();
    setLedRailEnabled(false);
    setSensorRailEnabled(false);
    LOGLN("GBox: STOP mode armed.");
}

uint16_t GBox::rawValueForPiece(BoxPieceId piece) const
{
    for (const AdcDecodeEntry &entry : kAdcDecodeTable) {
        if (entry.piece == piece) {
            return static_cast<uint16_t>((entry.minValue + entry.maxValue) / 2U);
        }
    }

    return 0;
}

BoxPieceId GBox::decodePiece(uint16_t rawValue) const
{
    for (const AdcDecodeEntry &entry : kAdcDecodeTable) {
        if (rawValue >= entry.minValue && rawValue <= entry.maxValue) {
            return entry.piece;
        }
    }

    return BoxPieceId::INVALID;
}

const char *GBox::pieceToString(BoxPieceId piece) const
{
    switch (piece) {
    case BoxPieceId::EMPTY:
        return "EMPTY";
    case BoxPieceId::FORWARD:
        return "FORWARD";
    case BoxPieceId::BACKWARD:
        return "BACKWARD";
    case BoxPieceId::TURN_RIGHT:
        return "TURN_RIGHT";
    case BoxPieceId::TURN_LEFT:
        return "TURN_LEFT";
    case BoxPieceId::LOOP_CALL:
        return "LOOP_CALL";
    default:
        return "INVALID";
    }
}

bool GBox::sendClearQueueCommand()
{
    if (_ctx.radioController == nullptr) {
        LOGLN("Radio controller unavailable for clear queue command.");
        return false;
    }

    CommandPacket packet{};
    packet.count = 2;
    packet.commands[0] = static_cast<uint8_t>(CommandId::MOTOR_STOP);
    packet.commands[1] = static_cast<uint8_t>(CommandId::QUEUE_CLEAR);

    LOG("Sending MOTOR_STOP and clear queue command.");
    LOGLN();

    return _ctx.radioController->sendBuffer(&packet, sizeof(packet));
}

bool GBox::isCurrentlyScanning() const
{
    return isScanning_;
}

void GBox::startScanning()
{
    isScanning_ = true;
    LOGLN("Scanning started.");
}

void GBox::interruptScanning()
{
    isScanning_ = false;
    LOGLN("Scanning interrupted by button press.");
}
