javierfileiv/gaspetto/soft/gaspetto_car/GaspettoCar.h

#pragma once

#include "Arduino.h"
#include "EventQueue.h"
#include "IdleState.h"
#include "ProcessingState.h"
#include "State.h"
#include <cstdint>
#define __ASSERT_USE_STDERR
#include <assert.h>
class GaspettoCar {
public:
  GaspettoCar(State *idle, State *running, EventQueue *queue,
              StateId initial_state);

  void transitionTo(StateId newStateId);
  void enqueue_random_commands(const uint8_t num_events);
  EventQueue getEventQueue() { return *eventQueue; }
  void processNextEvent(void);
  int postEvent(Event evt);
  void enterLowPowerMode(void);
  void Init(void);

private:
  void UpdateState(StateId &newStateId);

private:
  EventQueue *eventQueue;
  State *states[static_cast<int>(StateId::MAX_STATE_ID)];
  StateId currentStateId;
};
