javierfileiv/gaspetto/soft/emu-pc/shared_types/include/CommandPacket.h

#pragma once

#include "CommandId.h"

#include <stddef.h>
#include <stdint.h>

constexpr size_t BOX_TOTAL_SLOTS = 20;
constexpr size_t BOX_MAIN_SLOTS = 12;
constexpr size_t BOX_LOOP_SLOTS = 8;
constexpr size_t BOX_LED_COUNT = 3;
constexpr size_t BOX_MAX_PAYLOAD_COMMANDS = 31;

enum class BoxPieceId : uint8_t {
    EMPTY = 0,
    FORWARD,
    BACKWARD,
    TURN_RIGHT,
    TURN_LEFT,
    LOOP_CALL,
    INVALID,
};

using BoxBoardPieces = BoxPieceId[BOX_TOTAL_SLOTS];

struct __attribute__((packed)) CommandPacket {
    uint8_t count;
    uint8_t commands[BOX_MAX_PAYLOAD_COMMANDS];
};

static_assert(sizeof(CommandPacket) == 32, "CommandPacket must fit in a single nRF24 payload");
