javierfileiv/gaspetto/soft/emu-pc/arduino_framework/include/Arduino.h

#pragma once
#include "Arduino_pins_pc.h"
#include "Events.h"
#include "HardwareTimer.h"
#include "Serial.h"

#include <atomic>
#include <thread>

#ifndef ARDUINO
extern "C" Event getEmulatedEvent(void);
#endif

#define constrain(amt, low, high) ((amt) < (low) ? (low) : ((amt) > (high) ? (high) : (amt)))

extern std::atomic<bool> lowPowerMode;
extern std::atomic<unsigned long> microsCounter;
extern Event event;
extern SerialEmulator Serial;

#define digitalPinToPinName(pin) pin
#define pinmap_peripheral(pin, map) nullptr
#define pinmap_function(pin, map) pin
#define STM_PIN_CHANNEL(pin) pin

extern "C" {

unsigned long millis(void);
unsigned long micros(void);
void SwitchToLowPowerMode(void);
long map(long x, long in_min, long in_max, long out_min, long out_max);
void pinMode(int pin, int mode);
void attachInterrupt(int interruptNum, void (*userFunc)(void), int mode);
void analogWrite(int pin, int value);
int digitalPinToInterrupt(int pin);
void delay(int ms);
void analogWriteFrequency(int freq);
void printf_begin();
int digitalRead(int pin);
void digitalWrite(int pin, int value);
}
