javierfileiv/gaspetto/soft/emu-pc/targets/gcar/movement_controller/include/IMUOrientationInterface.h

#pragma once

#include <stdint.h>

#ifndef ARDUINO
class TwoWire; // Forward declaration for testing
#else
#include <Wire.h>
#endif
#define IMU_I2C_ADDR 0x68

class IMUOrientationInterface {
public:
    struct Offsets {
        float accX{ 0 }, accY{ 0 }, accZ{ 0 };
        float gyroX{ 0 }, gyroY{ 0 }, gyroZ{ 0 };
    };

    virtual ~IMUOrientationInterface() = default;

    virtual bool begin(uint8_t addr = 0x68, TwoWire *theWire =
#ifdef ARDUINO
                                                    &Wire
#else
                                                    nullptr
#endif
                       ) = 0;
    virtual void calibrate(bool print = true) = 0;
    virtual void update() = 0;

    virtual float roll() const = 0;
    virtual float pitch() const = 0;
    virtual float yaw() const = 0;
    virtual float gyroZDeg() const = 0;
    virtual void zeroYaw() = 0;
};
