javierfileiv/gaspetto/soft/emu-pc/arduino_framework/include/Arduino_pins_pc.h

#pragma once

#define F(x) x
#define PA0 3
#define PA1 4
#define PA3 5
#define PA4 4
#define PA8 8
#define PA9 9
#define PA_0 0
#define PA_1 1
#define PA_2 2
#define PA_3 3
#define PA_8 8
#define PA_4 4
#define PA_9 9
#define PB0 0
#define PB1 1
#define PB4 4
#define PB6 6
#define PB7 7
#define PB10 10
#define PB11 11
#define PB12 12
#define PB14 14
#define PB15 15
#define PB_10 10
#define PB_11 11
#define PB_12 12
#define PB_14 14
#define PB_15 15
#define PC13 113
#define PC14 114
#define PC_13 13
#define RISING 0
#define FALLING 1
#define LOW 0
#define HIGH 1
#define INPUT 0
#define INPUT_PULLUP 1
#define OUTPUT 2
#define OUTPUT_OPEN_DRAIN 3
#define INPUT_PULLDOWN 2
#define LOW 0
