javierfileiv/gaspetto/soft/emu-pc/state_machine_framework/TimeredEventQueue.h

#ifndef TIMERED_EVENT_QUEUE_H
#define TIMERED_EVENT_QUEUE_H

#include "ActiveObject.h"
#include "Arduino.h"
#include "Event.h" /*  Assuming you have your ActiveObject definition. */

#define MAX_TIMED_EVENT_NODES 15 /*  Define a maximum number of scheduled events. */

struct TimedEventNode {
    uint32_t triggerTimeMs;
    Event event;
    int8_t nextIndex; /*  Index of the next node in the array (-1 for null). */
    TimedEventNode()
            : triggerTimeMs(0)
            , nextIndex(-1)
    {
    }
};

class TimeredEventQueue {
public:
    TimeredEventQueue();
    bool scheduleAbsoluteTimeEvent(uint32_t timeMs, Event event); /*  Schedule based on absolute
                                                                     time. */
    bool scheduleEventDelayed(uint32_t delayMs, Event event); /*  Schedule based on delay. */
    void processEvents(ActiveObject &ao);
    void clear(); /*  Reset the queue. */

    static const char *eventIdToString(EventId id)
    {
        switch (id) {
        case EventId::NONE:
            return "NONE";
        case EventId::TIMER_ELAPSED:
            return "TIMER_ELAPSED";
        case EventId::NRF_IRQ:
            return "NRF_IRQ";
        case EventId::BUTTON_PRESSED:
            return "BUTTON_PRESSED";
        case EventId::MAX_EVENT_ID:
            return "MAX_EVENT_ID";
        default:
            return "UNKNOWN_EVENT_ID";
        }
    }

    static const char *commandIdToString(CommandId id)
    {
        switch (id) {
        case CommandId::NONE:
            return "NONE";
        case CommandId::MOTOR_FORWARD:
            return "MOTOR_FORWARD";
        case CommandId::MOTOR_BACKWARD:
            return "MOTOR_BACKWARD";
        case CommandId::MOTOR_RIGHT:
            return "MOTOR_RIGHT";
        case CommandId::MOTOR_LEFT:
            return "MOTOR_LEFT";
        case CommandId::MOTOR_STOP:
            return "MOTOR_STOP";
        case CommandId::MAX_COMMAND_ID:
            return "MAX_COMMAND_ID";
        default:
            return "UNKNOWN_COMMAND_ID";
        }
    }

private:
    uint32_t lastProcessTime_;
    TimedEventNode eventNodes_[MAX_TIMED_EVENT_NODES];
    int8_t headIndex_; /*  Index of the first event in the sorted list (-1 if
                          empty). */
    int8_t freeListHead_; /*  Index of the first free node in the array (-1 if
                             full). */
    int8_t allocateNode();
    void freeNode(uint8_t index);
};

#endif /* TIMERED_EVENT_QUEUE_H */
