javierfileiv/gaspetto/soft/gaspetto_car/EventQueue.cpp

#include "EventQueue.h"
#include "StateMachine.h"

bool EventQueue::enqueue(Event evt) {
  if (count == capacity) {
    // Queue is full
    return false;
  }
  events[tail] = evt;
  tail = (tail + 1) % capacity; // Wrap around if necessary
  ++count;
  return true;
}

// Dequeue an event
bool EventQueue::dequeue(Event &evt) {
  if (count == 0) {
    // Queue is empty
    return false;
  }
  evt = events[head];
  head = (head + 1) % capacity; // Wrap around if necessary
  --count;
  return true;
}

bool EventQueue::IsEmpty() const { return count == 0; }

bool EventQueue::IsFull() const { return count == capacity; }

size_t EventQueue::GetSize() const { return count; }
