javierfileiv/gaspetto/soft/Tests/arduino-tests/primo-prototype-arduino/cubetto/cubetto.ino

/*
http://primo.io

This sketch is part of the Primo Prototype Documentation.
http://docs.primo.io

Tested on the Arduino UNO.
Load this into Cubetto, the little cube robot.
*/

#define FORWARD 1
#define BACKWARD 0

// serial protocol
#define STOP 'O'
#define LEFT 'L'
#define RIGHT 'R'
#define FORWARD 'F'
#define INIT 'I'

// left motor
const int leftEnable = 13;
const int leftForward = 10;
const int leftReverse = 11;

// right motor
const int rightEnable = 12;
const int rightForward = 6;
const int rightReverse = 9;

// encoders
const int leftEncoder = A1;
const int rightEncoder = A4;

char instruction = 'O';

void setup()
{
    Serial.begin(9600);

    // initialize left
    pinMode(leftEnable, OUTPUT);
    pinMode(leftReverse, OUTPUT);
    pinMode(leftForward, OUTPUT);

    // initialize right
    pinMode(rightEnable, OUTPUT);
    pinMode(rightForward, OUTPUT);
    pinMode(rightReverse, OUTPUT);

    // enable motors
    digitalWrite(leftEnable, HIGH);
    digitalWrite(rightEnable, HIGH);

    // initialize aligns the wheels
    initialize();

    delay(2000);
}

void loop()
{
    // read rom the xbee
    if (Serial.available() > 0) {
        instruction = Serial.read();
    }

    // decode instruction
    switch (instruction) {
    case FORWARD:
        initialize();
        digitalWrite(11, HIGH);
        forward(128, 16);
        break;

    case LEFT:
        initialize();
        left(128, 9);
        break;

    case RIGHT:
        initialize();
        right(138, 7);
        break;

    case INIT:
        initialize();
        break;

    case STOP:
        stop();
        break;

    default:
        stop();
        break;
    }
}
