javierfileiv/gaspetto/soft/emu-pc/tests/mocks/mock_MotorControl.cpp

#include "mock_MotorControl.h"

MockMotorControl::MockMotorControl()
        : MockBase<MockMotorControl>()
{
    set_instance(this);
}

MockMotorControl::~MockMotorControl()
{
    clear_instance(this);
}

void MockMotorControl::init(uint32_t pwm_freq)
{
    auto mock = MockMotorControl::get_instance();
    mock->_init(pwm_freq);
}

void MockMotorControl::setMotorSpeeds(uint32_t leftSpeed, uint32_t rightSpeed, bool leftForward,
                                      bool rightForward)
{
    auto mock = MockMotorControl::get_instance();
    mock->_setMotorSpeeds(leftSpeed, rightSpeed, leftForward, rightForward);
}

void MockMotorControl::setPWMfrequency(uint32_t frequency)
{
    auto mock = MockMotorControl::get_instance();
    mock->_setPWMfrequency(frequency);
}

void MockMotorControl::setPWMdutyCycle(MotorSide side, PinPerSide pin, uint32_t percent_duty)
{
    auto mock = MockMotorControl::get_instance();
    mock->_setPWMdutyCycle(side, pin, percent_duty);
}

void MockMotorControl::stopBothMotors()
{
    auto mock = MockMotorControl::get_instance();
    mock->_stopBothMotors();
}
