javierfileiv/gaspetto/soft/emu-pc/tests/gbox/test_program_builder.cpp

#include "Adafruit_ADS1X15.h"
#include "GBox.h"
#include "Wire.h"
#include "board_presets.h"

#include <array>
#include <cstring>
#include <gtest/gtest.h>

TEST(GBoxProgramBuilderTest, ExpandsLoopSequenceIntoPayload)
{
    BoxPieceId board[BOX_TOTAL_SLOTS];
    gbox_test::fillEmptyBoard(board);
    CommandPacket packet{};
    bool isEmpty = false;

    board[0] = BoxPieceId::FORWARD;
    board[1] = BoxPieceId::TURN_RIGHT;
    board[2] = BoxPieceId::LOOP_CALL;
    board[3] = BoxPieceId::BACKWARD;

    board[12] = BoxPieceId::TURN_LEFT;
    board[13] = BoxPieceId::FORWARD;
    board[14] = BoxPieceId::BACKWARD;

    const bool ok = GBox::buildProgramFromPieces(board, packet, isEmpty);

    ASSERT_TRUE(ok);
    ASSERT_FALSE(isEmpty);
    ASSERT_EQ(packet.count, 6);
    EXPECT_EQ(packet.commands[0], static_cast<uint8_t>(CommandId::MOTOR_FORWARD));
    EXPECT_EQ(packet.commands[1], static_cast<uint8_t>(CommandId::MOTOR_TURN_RIGHT));
    EXPECT_EQ(packet.commands[2], static_cast<uint8_t>(CommandId::MOTOR_TURN_LEFT));
    EXPECT_EQ(packet.commands[3], static_cast<uint8_t>(CommandId::MOTOR_FORWARD));
    EXPECT_EQ(packet.commands[4], static_cast<uint8_t>(CommandId::MOTOR_BACKWARD));
    EXPECT_EQ(packet.commands[5], static_cast<uint8_t>(CommandId::MOTOR_BACKWARD));
}

TEST(GBoxProgramBuilderTest, RejectsEmptyBoard)
{
    BoxPieceId board[BOX_TOTAL_SLOTS];
    gbox_test::fillEmptyBoard(board);
    CommandPacket packet{};
    bool isEmpty = false;

    const bool ok = GBox::buildProgramFromPieces(board, packet, isEmpty);

    EXPECT_FALSE(ok);
    EXPECT_TRUE(isEmpty);
    EXPECT_EQ(packet.count, 0);
}

TEST(GBoxProgramBuilderTest, RejectsOverflowingLoopExpansion)
{
    BoxPieceId board[BOX_TOTAL_SLOTS];
    std::memcpy(board, gbox_test::kOverflowBoardPieces, sizeof(board));
    CommandPacket packet{};
    bool isEmpty = false;

    const bool ok = GBox::buildProgramFromPieces(board, packet, isEmpty);

    EXPECT_FALSE(ok);
    EXPECT_FALSE(isEmpty);
    EXPECT_EQ(packet.count, BOX_MAX_PAYLOAD_COMMANDS);
}

TEST(GBoxProgramBuilderTest, IgnoresLoopCallInLoopAreaWhenNoOtherPieces)
{
    BoxPieceId board[BOX_TOTAL_SLOTS];
    gbox_test::fillEmptyBoard(board);
    CommandPacket packet{};
    bool isEmpty = false;

    board[0] = BoxPieceId::LOOP_CALL;
    board[14] = BoxPieceId::LOOP_CALL;

    const bool ok = GBox::buildProgramFromPieces(board, packet, isEmpty);

    EXPECT_FALSE(ok);
    EXPECT_TRUE(isEmpty);
    EXPECT_EQ(packet.count, 0);
}

TEST(GBoxProgramBuilderTest, IgnoresLoopCallInLoopArea)
{
    BoxPieceId board[BOX_TOTAL_SLOTS];
    gbox_test::fillEmptyBoard(board);
    CommandPacket packet{};
    bool isEmpty = false;

    board[0] = BoxPieceId::LOOP_CALL;
    board[14] = BoxPieceId::LOOP_CALL;
    board[15] = BoxPieceId::FORWARD;

    const bool ok = GBox::buildProgramFromPieces(board, packet, isEmpty);

    ASSERT_TRUE(ok);
    ASSERT_FALSE(isEmpty);
    ASSERT_EQ(packet.count, 1);
    EXPECT_EQ(packet.commands[0], static_cast<uint8_t>(CommandId::MOTOR_FORWARD));
}

TEST(GBoxProgramBuilderTest, SupportsThreeLoopCallsWithFullLoopZone)
{
    BoxPieceId board[BOX_TOTAL_SLOTS];
    gbox_test::fillEmptyBoard(board);
    CommandPacket packet{};
    bool isEmpty = false;

    /* 3 x 8 loop commands + 1 backward = 25, still within the 31 command payload. */
    board[0] = BoxPieceId::LOOP_CALL;
    board[1] = BoxPieceId::LOOP_CALL;
    board[2] = BoxPieceId::LOOP_CALL;
    board[3] = BoxPieceId::BACKWARD;

    board[12] = BoxPieceId::FORWARD;
    board[13] = BoxPieceId::BACKWARD;
    board[14] = BoxPieceId::TURN_RIGHT;
    board[15] = BoxPieceId::TURN_LEFT;
    board[16] = BoxPieceId::BACKWARD;
    board[17] = BoxPieceId::FORWARD;
    board[18] = BoxPieceId::TURN_RIGHT;
    board[19] = BoxPieceId::BACKWARD;

    const bool ok = GBox::buildProgramFromPieces(board, packet, isEmpty);

    ASSERT_TRUE(ok);
    ASSERT_FALSE(isEmpty);
    ASSERT_EQ(packet.count, 25);
}

TEST(GBoxProgramBuilderTest, RejectsFourthLoopCallWithFullLoopZone)
{
    BoxPieceId board[BOX_TOTAL_SLOTS];
    gbox_test::fillEmptyBoard(board);
    CommandPacket packet{};
    bool isEmpty = false;

    /* 4 x 8 = 32 commands, one beyond the 31 command payload. */
    board[0] = BoxPieceId::LOOP_CALL;
    board[1] = BoxPieceId::LOOP_CALL;
    board[2] = BoxPieceId::LOOP_CALL;
    board[3] = BoxPieceId::LOOP_CALL;
    board[4] = BoxPieceId::BACKWARD;

    board[12] = BoxPieceId::FORWARD;
    board[13] = BoxPieceId::BACKWARD;
    board[14] = BoxPieceId::TURN_RIGHT;
    board[15] = BoxPieceId::TURN_LEFT;
    board[16] = BoxPieceId::BACKWARD;
    board[17] = BoxPieceId::FORWARD;
    board[18] = BoxPieceId::TURN_RIGHT;
    board[19] = BoxPieceId::BACKWARD;

    const bool ok = GBox::buildProgramFromPieces(board, packet, isEmpty);

    EXPECT_FALSE(ok);
    EXPECT_FALSE(isEmpty);
    EXPECT_EQ(packet.count, BOX_MAX_PAYLOAD_COMMANDS);
}

TEST(GBoxProgramBuilderTest, RejectsInvalidTokenInMainArea)
{
    BoxPieceId board[BOX_TOTAL_SLOTS];
    gbox_test::fillEmptyBoard(board);
    CommandPacket packet{};
    bool isEmpty = false;

    board[0] = BoxPieceId::INVALID;

    const bool ok = GBox::buildProgramFromPieces(board, packet, isEmpty);

    EXPECT_FALSE(ok);
    EXPECT_FALSE(isEmpty);
}

TEST(GBoxProgramBuilderTest, RejectsUnknownMainTokenValue)
{
    BoxPieceId board[BOX_TOTAL_SLOTS];
    gbox_test::fillEmptyBoard(board);
    CommandPacket packet{};
    bool isEmpty = false;

    board[0] = static_cast<BoxPieceId>(0xFF);

    const bool ok = GBox::buildProgramFromPieces(board, packet, isEmpty);

    EXPECT_FALSE(ok);
    EXPECT_FALSE(isEmpty);
}

TEST(GBoxProgramBuilderTest, RejectsOverflowWhenAppendingRegularMainPiece)
{
    BoxPieceId board[BOX_TOTAL_SLOTS];
    gbox_test::fillEmptyBoard(board);
    CommandPacket packet{};
    bool isEmpty = false;

    /* 5 loop calls with 6 loop commands each => 30 commands. */
    board[0] = BoxPieceId::LOOP_CALL;
    board[1] = BoxPieceId::LOOP_CALL;
    board[2] = BoxPieceId::LOOP_CALL;
    board[3] = BoxPieceId::LOOP_CALL;
    board[4] = BoxPieceId::LOOP_CALL;

    /* One normal append reaches 31, next normal append must fail. */
    board[5] = BoxPieceId::FORWARD;
    board[6] = BoxPieceId::BACKWARD;

    board[14] = BoxPieceId::FORWARD;
    board[15] = BoxPieceId::BACKWARD;
    board[16] = BoxPieceId::TURN_LEFT;
    board[17] = BoxPieceId::TURN_RIGHT;
    board[18] = BoxPieceId::BACKWARD;
    board[19] = BoxPieceId::FORWARD;

    const bool ok = GBox::buildProgramFromPieces(board, packet, isEmpty);

    EXPECT_FALSE(ok);
    EXPECT_FALSE(isEmpty);
    EXPECT_EQ(packet.count, BOX_MAX_PAYLOAD_COMMANDS);
}

TEST(GBoxProgramBuilderTest, MapsSlotsToExpectedAdsBusesAndAddresses)
{
    AdsRouteInfo route{};

    /* Board wiring: slots 0-3 on 0x4B, 4-7 on 0x48, 8-11 on 0x4A, 12-15 on 0x49 */
    const uint8_t expectedAddress[16] = { 0x4B, 0x4B, 0x4B, 0x4B, 0x48, 0x48, 0x48, 0x48,
                                          0x4A, 0x4A, 0x4A, 0x4A, 0x49, 0x49, 0x49, 0x49 };

    for (std::size_t slot = 0; slot < 16; ++slot) {
        ASSERT_TRUE(GBox::routeForSlot(slot, route));
        EXPECT_FALSE(route.usesI2c3);
        EXPECT_EQ(route.address, expectedAddress[slot]);
        EXPECT_EQ(route.channel, static_cast<uint8_t>(slot % 4));
    }

    for (std::size_t slot = 16; slot < BOX_TOTAL_SLOTS; ++slot) {
        ASSERT_TRUE(GBox::routeForSlot(slot, route));
        EXPECT_TRUE(route.usesI2c3);
        EXPECT_EQ(route.address, 0x4A);
        EXPECT_EQ(route.channel, static_cast<uint8_t>(slot - 16));
    }

    EXPECT_FALSE(GBox::routeForSlot(BOX_TOTAL_SLOTS, route));
}

TEST(AdafruitAdsEmulationTest, AsyncReadReturnsMuxSelectedI2c3RawValue)
{
    Adafruit_ADS1115::resetPattern();
    Adafruit_ADS1115::setRawValue(16, 1234);
    Adafruit_ADS1115::setRawValue(19, 3210);

    TwoWire i2c3;
    Adafruit_ADS1115 ads;

    ASSERT_TRUE(ads.begin(0x4A, &i2c3));

    ads.startADCReading(ADS1X15_REG_CONFIG_MUX_SINGLE_0, false);
    EXPECT_TRUE(ads.conversionComplete());
    EXPECT_EQ(1234, ads.getLastConversionResults());

    ads.startADCReading(ADS1X15_REG_CONFIG_MUX_SINGLE_3, false);
    EXPECT_TRUE(ads.conversionComplete());
    EXPECT_EQ(3210, ads.getLastConversionResults());

    Adafruit_ADS1115::resetPattern();
}

TEST(AdafruitAdsEmulationTest, RejectsUnexpectedI2c3Address)
{
    TwoWire i2c3;
    Adafruit_ADS1115 ads;

    EXPECT_FALSE(ads.begin(0x48, &i2c3));
}
