javierfileiv/gaspetto/soft/emu-pc/tests/mocks/mock_arduino.cpp

#include "mock_Arduino.h"

#include "Arduino.h"
#include "GCar.h" /* Need for pin definitions. */
#include "fixture.h"

#include <atomic>
#include <gmock/gmock.h>

extern std::atomic<bool> lowPowerMode;

MockArduino::MockArduino()
{
    set_instance(this);
}

MockArduino::~MockArduino()
{
    clear_instance(this);
}

void pinMode(int pin, int mode)
{
    auto mock = MockArduino::get_instance();

    mock->pinMode(pin, mode);
}

void attachInterrupt(int interruptNum, void (*userFunc)(void), int mode)
{
    auto mock = MockArduino::get_instance();

    mock->attachInterrupt(interruptNum, userFunc, mode);
}

void analogWrite(int pin, int value)
{
    auto mock = MockArduino::get_instance();

    mock->analogWrite(pin, value);
}

void digitalWrite(int pin, int value)
{
    auto mock = MockArduino::get_instance();

    mock->digitalWrite(pin, value);
}

int digitalPinToInterrupt(int pin)
{
    return pin;
}

void delay(int ms)
{
    auto mock = MockArduino::get_instance();

    mock->delay(ms);
}

void SwitchToLowPowerMode(void)
{
    auto mock = MockArduino::get_instance();

    mock->SwitchToLowPowerMode();
    low_power_mode = true;
}

void analogWriteFrequency(int freq)
{
    auto mock = MockArduino::get_instance();

    mock->analogWriteFrequency(freq);
}

unsigned long millis(void)
{
    auto mock = MockArduino::get_instance();

    return mock->millis();
}

unsigned long micros(void)
{
    auto mock = MockArduino::get_instance();

    return mock->micros();
}

HardwareTimer::HardwareTimer()
{
}

HardwareTimer::HardwareTimer(TIM_TypeDef *instance)
{
}

void HardwareTimer::setCaptureCompare(uint32_t channel, uint32_t compare,
                                      TimerCompareFormat_t format)
{
    auto mock = MockArduino::get_instance();

    mock->setCaptureCompare(channel, compare, format);
}

void HardwareTimer::setPWM(uint32_t channel, PinName pin, uint32_t frequency, uint32_t dutycycle)
{
    auto mock = MockArduino::get_instance();

    mock->setPWM(channel, pin, frequency, dutycycle);
}

void HardwareTimer::pause()
{
    auto mock = MockArduino::get_instance();

    mock->hw_timer_pause();
}

extern "C" {

long map(long x, long in_min, long in_max, long out_min, long out_max)
{
    return (x - in_min) * (out_max - out_min) / (in_max - in_min) + out_min;
}
}
