javierfileiv/gaspetto/(commit log)

2026-04-09 feat: add gaspetto_box program
    - PC emulation
    - PIO program
    - Utest integration
    -minor fixes on Car program
    [Arduino_pins_pc.h, CarEvents.h, CarStates.h, CommandId.h, CommandPacket.h, Context.h, GaspettoBox.cpp, GaspettoBox.h]
2026-04-30 fix: minor fixes testing box hardware setup
    [main.cpp, pin_definitions.h]
2026-04-30 add useful nrf24 arduino tests
2026-04-30 deleted document, reorder
    [cubetto-4mm.dxf, cubetto.stl, fence-4mm.dxf, house-3mm.dxf, instruction-blocks-1mm.dxf, instruction-blocks-4mm.dxf, interface-board-1mm.dxf, interface-board-4mm.dxf]
2026-04-30 mods on hall sensor ino, add python csv processing
2026-04-30 car: both pwm working in 2 different channels
2026-04-30 car: add quick motor fordward backward test
2026-04-30 car: clean program, motor 1 stopped working.
    To check what happened
2026-04-30 car: add motor controller
2026-04-30 nrfbridge: remove debug print
2026-04-30 rx: changes to run on stm32f103, not tested with nrf24l01 yet
2026-04-30 kicad: add gaspetto schematic + kicad libs
    [gaspetto.kicad_sch]
2026-04-30 rx_stm: adaapt pinout to new schematic
2026-04-30 add last modif before switching from vscode to nvim
2026-04-30 cad: add cubetto controller design
    OH49E datasheet added
    [gaspetta-box.FCStd]
2026-04-30 cad: mod to svg
    [gaspetta-box.FCStd]
2026-04-30 kicad: organize datasheet and implement schematics
    [gaspetto.kicad_pcb, gaspetto.kicad_sch, prototipo.kicad_pcb, prototipo.kicad_sch]
2026-04-30 arduino: add useful scripts
2026-04-30 arduino:remove useless examples
2026-04-30 cpp: last button changes with keyboard
2026-04-30 ino:add motor control
2026-04-30 ino: add pwm test
2026-04-30 kicad: add schematics gaspetto car and box
    [prototipo_gaspetto_box.kicad_sch, prototipo_gaspetto_car.kicad_sch]
2026-04-30 freecad: change name
    [gaspetto-box.FCStd]
2026-04-30 motor_control: remove folder
2026-04-30 kicad: clean projects
    [gaspetto.kicad_pcb, gaspetto.kicad_sch, prototipo.kicad_pcb, prototipo.kicad_sch, prototipo_gaspetto_box.kicad_sch, prototipo_gaspetto_car.kicad_sch]
2026-04-30 soft: update working rx tx STM/Arduino
    now, one device must be 0, and the other number 1.
    With R or T, you change mode to RX or TX.
2026-04-30 soft: remove stm32 nrf24 lib
2026-04-30 gitignore: add kicad lock files
2026-04-30 box/car src: organize and adapt to PC framework
2026-04-30 car: add timered event to test commands
2026-04-30 car: add motor handle logic
2026-04-30 box/car: prepare to build with arduino
2026-04-30 arduino-tests: move folder
    [SensorData.csv]
2026-04-30 car/box: replace arduino by platformio
    [ActiveObject.h, Arduino.cpp, Arduino.h, Event.h, EventQueue.cpp, EventQueue.h, GaspettoBox.cpp, GaspettoBox.h]
2026-04-30 car: fix issues with timered queue
    [ActiveObject.h, GaspettoCar.h, ProcessingState.cpp, TimeredEventQueue.h, main.cpp]
2026-04-30 sch: gaspetto car match with what's in the board
    [prototipo_gaspetto_car.kicad_sch]
2026-04-30 sch car: update schematic
    [prototipo_gaspetto_car.kicad_sch]
2026-04-30 wip motor turning and speed sensor
2026-04-30 TimeredQueue: fix bug regarding index
    [TimeredEventQueue.h]
2026-04-30 car: motor and radio
    - We receive radio commands and execute them. I have some issues
    controlling DC motors, will try to restructure a bit and add
    a PID controller.
    [prototipo_gaspetto_car.kicad_sch]
2026-04-30 motor control: use hardware timers instead
2026-04-30 car/box: big architecture changes to prepare for PID
    - Introduce MovementController
    - Add Log class to centralize logging.
    - Add context for car and box to centralize dependencies.
2026-04-30 car: schematic add mpu 6050
    [prototipo_gaspetto_car.kicad_sch]
2026-04-30 car: mods to Gaspetto to test hardware timers
    The test uses timered event queue, send all 4 possible command.
    Check it with Salaea on 4Mhz sampling freq a 500M samples.
2026-04-30 sch: good gpio pinout labels for motor
    Change GPIO pins for harware timer in bluepill
    [prototipo_gaspetto_car.kicad_sch]
2026-04-30 sch: add blackpill new connections
    [prototipo_gaspetto_car.kicad_sch]
2026-04-30 car: add pin definitions header for tests
2026-04-30 test: add test drive straight program
    There are some thing when turning in position. But going forward is working fantastic! use speed 35 for PWM.
2026-04-30 test: add program to plot MPU values
    A program that prints on serial and a python script
    to plot IMU values.
2026-04-30 framework: add MPU and PID stub to framework
2026-04-30 box/car: integrate IMU into program
    - Whole FSM has been changed iso-functional.
    - mock utest has been update.
2026-05-01 feat: add clear queue command when button is pressed again on box
2026-05-06 fix: format change due to clang-format 22
    [mock_RF24.h, stringstream.h]
2026-05-06 feat: add gaspetto box sch
    [prototipo_gaspetto_box.kicad_sch]
2026-05-06 docs: add ads1115 breakout board sch
2026-05-06 refactor: remove useless arduino tests
2026-05-06 feat: add IMU emulation for PC emulator
    [imu_sample.csv]
2026-07-10 feat: fix assert macro, more safety
    [__assert.h]
2026-07-10 feat: remove duplicated code 'motor_test'
2026-07-14 feat: remove impossible test case
2026-07-14 fix: remove low power unused library to NRFSender
2026-07-14 fix(car): fix compatible RTC version with low power framework
2026-07-14 fix(emu): add pin compatibility
    [Arduino_pins_pc.h, GaspettoCar.h]
2026-07-14 refactor: rename GaspettoCar into GCar
    - No need to make Gaspetto appear in name, it's too long and the
    project already has this name.
    [CarStates.h, Context.h, GCar.cpp, GCar.h, GaspettoCar.cpp, GaspettoCar.h, IMUOrientation.cpp]
2026-07-15 refactor: rename GaspettoBox into GBox
    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
    [Context.h, GBox.cpp, GBox.h, GaspettoBox.cpp, GaspettoBox.h, IdleState.cpp, IdleState.h, ProcessingState.cpp]
2026-07-15 fix: replace c++ array with fixed memory array
    [ActiveObject.h, CarEvents.h, CarStates.h, CommandPacket.h, Event.h, EventQueue.h, board_presets.h]
2026-07-15 refactor(): unify pin source of truth
    - Pin definition were scather all over several files.
    Use only one source of truth.
    - Unused send_values test, removed
2026-07-17 refactor: unify straight_drive and tune PID
    - Straight_drive uses same movementController as GCar
    - Commands tuned for W35 (forward), S35 (backward), A50 (turn 90 left),
    D50 (turn 90 right)
    - Replace inline PID in motor_test_main with MovementController from
    emu-pc targets/gcar (symlinks, no file copies)
    - Fix I2C init bug: IMUOrientationInterface default TwoWire* was nullptr
    on ARDUINO → now &Wire via #ifdef
    - MotorControl: replace broken HardwareTimer PWM with proven analogWrite
    (17Hz, matching commit a7dda9c behavior)
    - Fix PID correction sign for this hardware (left = speedScale - corr*0.5)
    - Restore PID defaults to Kp=2.0 Ki=0.01 Kd=0.01, normalisation /180,
    static clamp ±0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
    [GCar.h, IMUOrientation.cpp, IMUOrientation.h, MotorControl.cpp, MotorControl.h, MotorControlInterface.h, MovementController.cpp, MovementController.h]
2026-07-17 fix: update CE/CSN pin for NRF24L01
    [config_radio.h]
2026-07-17 feat: add assert if IMU not connected
2026-07-17 fix: change default parameters for Interface
    - GCar was using an interface that doesn't inherit default
    parameters from its base class in C++, pass them explicitly.
    [IMUOrientationInterface.h]
2026-07-17 refactor: make straight drive use same source files for IMU
2026-07-17 feat: come back to old code that works
    - Use old arduino_straight_drive test code
    that was working and start with a good base.
2026-07-17 fix: improve and fixes on arduino_straight_drive sender
    - Add length check before toCharArray in program queue to prevent
    buffer overflow when cmd >= CMD_LEN (16 bytes)
    - Reset telemetryCount when expectTelemetry triggers display so
    throttling resets predictably after manual 'b' command
    - Show PROGRAM_MAX in program queue feedback (e.g. 'Added to program
    (3/10)') for clarity
    [motor_test_sender_main.cpp]
2026-07-18 test: add coverage for trim, tunings, turn timeout, telemetry callbacks
    - setTunings() updates PID values verified via buildTelemetryPacket
    - setTrim() affects telemetry.trim and asymmetrically shifts motor speeds
    - Turn timeout stops movement after 4 seconds
    - Turning state reflected in telemetryPacket.state
    - checkTelemetry invokes callback when set, no crash when null
    - Fix MotorControl test: analogWriteFrequency expected 1x (was 2x)
    Coverage back to 97.0% (above 95% gate).
    [test_pid_movement.cpp]
2026-07-18 docs: add tuning section to README
    Document the motor_test_main / motor_test_sender workflow:
    hardware targets, flash commands, all supported commands
    (W/S/A/D for movement, K/I/V for PID, O for trim, B for
    debug telemetry), telemetry format, and note that PID
    tuning is shared with GCar firmware via symlinks.
2026-10-05 fix(pio): pin ststm32 platform to 19.6.0
    The ststm32 platform was left unpinned, so a local update moved it from
    19.6.0 to 20.0.0 and pulled Arduino Core STM32 3.0.0 instead of 2.12.0.
    The new core removed SPIClass::setBitOrder/setDataMode/setClockDivider,
    breaking arduino_car_hw_test, and added a voidFuncPtr typedef that
    collides with STM32duino RTC, breaking GCar.
    Pin the platform in the projects staying on core 2.12 so builds remain
    reproducible, and drop STM32duino RTC and STM32duino Low Power from GCar:
    both are declared but never included by any source file.
    GBox_pio and arduino_box_hw_test are deliberately left unpinned. They are
    about to gain a bit-banged I2C3 whose Adafruit wrappe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
2026-10-05 refactor: split USE_RADIO_CONTROLLER into separate PC_KEYBOARD_RADIO_SIM flag
    Separate concerns: USE_RADIO_CONTROLLER now controls GCar event source
    (radio vs timered queue), while PC_KEYBOARD_RADIO_SIM controls PC keyboard
    input mode (radio simulation vs direct events). This makes the two
    functionalities independent and clearer.
2026-10-05 fix(gbox): change nRF24L01 SPI pins to avoid I2C3 conflict
    Move NRF24_CE from PA8 to PA3 and NRF24_CSN from PA9 to PA4.
    PA8 was conflicting with I2C3_SCL_PIN which is also assigned to PA8.
    [config_radio.h]
2026-10-06 feat(gbox): add I2C3 bit-banging implementation and hardware test
    The hardware I2C3 peripheral on PB4/PA8 is not dependable on the STM32F411CE:
    initialisation and device detection succeed, but real conversions misbehave
    during reads. i2c3_bitbang drives the two lines in software instead, at about
    33kHz. Only the low side is driven; releasing a line lets the 4k7 pull-ups of
    the ADS1115 module do the rising edge, which is what bounds the rate.
    Adafruit_ADS1X15 accepts nothing but a TwoWire*, so the bit-bang is exposed
    through BitBangWire, which derives from TwoWire for that compatibility alone.
    It reaches the bit-bang only from Arduino Core STM32 3.0.0, where TwoWire
    derives from arduino::Har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
2026-10-06 feat(gbox): integrate I2C3 bit-banging into hardware test
    Replace TwoWire I2C3 usage with the bit-banging implementation in the box
    hardware test, so the bench exercises the same path the box firmware will use
    on PB4/PA8, where the STM32 hardware peripheral misbehaves.
    Each device entry now carries a useBitBang flag and the bit-bang branch talks
    through i2c3_bb_probe(), i2c3_bb_read_register() and i2c3_bb_write_register()
    instead of a TwoWire instance. Recovery reinitialises the bit-bang only, which
    matters because the old path called end(), begin() and setClock() on a TwoWire
    reference and would have handed the pins back to the hardware peripheral it
    was meant to repair.
    TwoWire is left u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
    [i2c3_bitbang.cpp, i2c3_bitbang.h, main.cpp]
2026-10-06 fix(gbox): stop motors before clearing the queue
    sendClearQueueCommand() queued QUEUE_CLEAR ahead of MOTOR_STOP, and the
    car processes QUEUE_CLEAR by clearing the pending event queue
    (ProcessingState.cpp). The stop command sitting behind the clear was
    therefore discarded by the very packet meant to stop the car.
    Emit MOTOR_STOP first so the stop always takes effect, then QUEUE_CLEAR
    to drop whatever movement commands remain.
    [GBox.cpp, test_button_interrupt.cpp]
2026-10-06 fix(radio): test GBOX with defined() in config_radio.h
    The branch chain read `#ifdef GCAR` then `#elif GBOX`. The second form
    tests the value of the macro, not its presence: it selects the GBox pins
    today only because -DGBOX implies -DGBOX=1. A future -DGBOX=0, or any
    other non-1 value, would silently fall through to the utest default of
    CE/CSN on pin 0 while still looking like a GBox build.
    Use defined() so both sides of the chain test presence, which is what the
    surrounding code means.
    [config_radio.h]
2026-10-06 style: rename shared types and switch include guards to pragma once
    CarEvents.h and CarStates.h are included by GCar, GBox, nrf_sender, the
    radio controller and the test fixtures: the names claimed a car target
    for the shared layer. Event.h sat beside Events.h with a different
    meaning, which reads as a typo. Renamed to Events.h, States.h and
    GenericEvent.h.
    The guards were hand-rolled #ifndef/#define/#endif triples, each spelling
    its own macro name, so each header carried a silent collision risk that
    #pragma once removes along with the boilerplate.
    Mechanical only, no behaviour change: skip this commit when reviewing.
    [ActiveObject.h, Arduino.cpp, Arduino.h, Context.h, EventQueue.h, Events.h, GBox.cpp, GBox.h]
2026-10-06 feat(gbox): route I2C3 through the BitBangWire wrapper in production
    The driver and BitBangWire wrapper landed in commit 69908a4 and were
    validated through a dedicated hardware test. GBox.cpp still held a plain
    TwoWire on PB4/PA8, which only reaches real pins on the GBox board
    through the bit-bang shim: the STM32F411 has I2C1 and I2C2 peripherals
    but no I2C3.
    Wire gI2c3 through BitBangWire under #ifdef ARDUINO, leaving PC builds
    on the existing TwoWire shim path. Add symlinks in GBox_pio so the
    bit-bang driver is part of the production build, and pin GBox_pio to
    ststm32@20.0.0 so the virtual dispatch BitBangWire relies on stays
    available.
2026-10-06 chore(deps): pin library versions across all PIO targets
    Replace caret ranges with exact versions to ensure reproducible builds:
    GCar targets (GCar_pio, arduino_car_hw_test, arduino_straight_drive, mpu_plot):
    - nrf24/RF24: ^1.5.0 → 1.6.2
    - adafruit/Adafruit MPU6050: ^2.2.6 → 2.2.9
    - adafruit/Adafruit Unified Sensor: ^1.1.15 → 1.1.15
    - br3ttb/PID: ^1.2.1 → 1.2.1
    GBox targets (GBox_pio, arduino_box_hw_test, arduino_i2c3_bb_test):
    - nrf24/RF24: ^1.5.0 → 1.6.2
    - adafruit/Adafruit ADS1X15: ^2.5.0 → 2.6.2
    - adafruit/Adafruit NeoPixel: ^1.12.3 → 1.15.5
    NRF utilities (NrfLogReceiver_pio, NrfSender_pio):
    - nrf24/RF24: ^1.5.0 → 1.6.2
    Transitive deps (BusIO 1.17.4, GFX Library 1.12.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
2026-10-06 feat(gbox): add boot-time hardware health check
    After initHardware(), GBox probes all expected peripherals:
    - I2C1: ADS1115 at addresses 0x48, 0x49, 0x4A, 0x4B
    - I2C3: ADS1115 at address 0x4A via bit-bang
    - nRF24L01+: radio chip presence
    Each probe result is logged ([OK] or [FAIL]). The first NeoPixel LED
    shows green if all peripherals respond, red if any fails. The LED state
    is held for 1.5 seconds then turned off.
    On PC builds, runHealthCheck() returns true unconditionally. The
    isChipConnected() method was added to RadioController and the RF24
    shim to support the radio probe.
    [GBox.cpp, GBox.h, RadioController.h, main.cpp]
2026-10-06 chore(tests): remove obsolete stub_RF24.cpp
    Obsolete since RF24.cpp is now always compiled in
    arduino_framework_impl (no longer conditional on
    NOT BUILD_TESTS). Caused multiple definition conflicts
    when linked with tests.
2026-10-06 feat(ci): add local commitlint hook matching CI rules
    Add tools/check-commit-msg script that validates
    conventional commit format with the same rules as
    the GitHub Actions CI:
    - Types: feat, fix, chore, refactor, docs, test, style,
    perf, ci, build, revert
    - Body lines max 100 characters
    (from @commitlint/config-conventional)
    - Subject max 72 characters (recommended)
    Hook runs at commit-msg stage to catch errors before push.
2026-10-07 feat(gbox): widen loop zone to 8 slots
    Shift the loop zone boundary from slots 14-19 to 12-19 (8 pieces),
    keeping the 20-slot board unchanged. A full loop zone caps the
    program at three LOOP_CALL expansions before payload overflow.
    Tests cover the shifted boundary, the three valid LOOP_CALLs with a
    full loop zone, the fourth call rejection and a minimal overflowing
    board preset.
2026-10-07 docs(gbox): document led behaviour and rename BOX_LED_SLOTS
    Rename BOX_LED_SLOTS to BOX_LED_COUNT since they are LEDs, not slots
    and drop the duplicated local kLedCount constant.
    Document the expected LED behaviour next to the led role constants:
    health check green/red at boot, cyan scan bounce, green cascade on
    accepted program, red build error, amber empty board and red radio
    error holds.
    [CommandPacket.h, GBox.cpp, main.cpp]
2026-10-07 feat(gbox): ignore loop-call pieces in the loop zone
    A LOOP_CALL piece in the loop area is now skipped instead of failing
    the build; INVALID still fails. PC emulation never built a program
    because the mock ADC default pattern decoded LOOP_CALL in loop
    slots, so the pattern now leaves the loop zone empty.
    [GBox.cpp, test_program_builder.cpp]
2026-10-07 feat(gbox): remove the stop piece from the board
    Physically the stop piece does not exist; the car stops by itself
    once the target is reached. The LOOP_CALL piece takes the ex-stop
    ADC range 2500-3099 instead, the old loop range 3100-4095 is left
    unused (reads there decode as INVALID).
    CommandId::MOTOR_STOP stays in the radio protocol for the queue
    clear command. Tests and board presets replace stop pieces with
    backward pieces, mock demo pattern uses forward values, thresholds
    are placeholders until re-measured on the physical board.
    [CommandPacket.h, GBox.cpp, board_presets.h, main.cpp, test_program_builder.cpp]
2026-10-07 docs: describe the game in the readme
    Explain what Gaspetto is as a game: the Box programming board with
    its piece zones and lights language, the GCar robot and how a round
    of play goes from arranged pieces to a running program.
2026-10-07 feat(pio): switch hw-test modes over usb cdc
    Runtime modes replace the compile-time TEST_PIECE_THRESHOLD_CALIBRATION
    flag: 'h' runs the health cycle, 'c' switches to piece calibration,
    '?' prints the current mode. Both paths now live in the same binary.
    Delays are sliced into 50ms windows polling the USB commands so a mode
    switch is picked up almost instantly. Both cycles bail out when the
    mode changed while they were waiting, leaving the rails exactly as the
    new mode set them; otherwise the old cycle would tear the 3V3 rail down
    under calibration. Entering a mode forces its rail state right away.
    [main.cpp]
2026-10-07 feat(pio): run health test on demand
    The health cycle no longer loops: after one run at boot, quiet idle
    polls the USB port with a heartbeat LED only. 's' reruns the test in
    any mode, 'h'/'c' rerun their own mode test when already active.
    Each health run ends with a change report comparing the ADS probes
    and the nRF24 chip state against the previous run: one line when
    unchanged, the transitions otherwise.
    [main.cpp]
2026-10-07 refactor: share piece thresholds between production and hw test
    Piece thresholds move from GBox.cpp into the new piece_thresholds.h,
    included by the production firmware and through a symlink by the
    arduino_box_hw_test tool: same numbers nowhere to diverge.
    The tool drops its TEST_THRESHOLD_* defines and duplicate asserts;
    threshold override comments leave platformio.ini since editing the
    header is the single override point now.
2026-10-13 feat(pio): label pieces and emit piece_thresholds header
    Usb keys in the box hw test: '<slot><label>' tags pieces with a quick
    ADS read, outlier guard keeps clusters clean, R clears a slot back.
    t sorts ranges and flags overlaps, x prints a paste-ready
    piece_thresholds.h block with raw midpoints. README documents modes,
    workflow and the raw-only scale (12-bit columns dropped).
2026-10-13 feat(gbox): add EMPTY_START threshold macro
    Add GASPETTO_ADC_THRESHOLD_EMPTY_START macro with placeholder value
    (1000, between BACKWARD_START=700 and TURN_RIGHT_START=1300) to prepare
    for the game-mode calibration workflow.
    Add corresponding static_assert to enforce threshold ordering.
    Real values will be filled after calibration campaign.
2026-10-13 feat(pio): monitor a chosen slot continuously
    '<slot>m' or bare 'm' streams ~5 mean reads per second with running
    min/max, stops on any key and prints an n/mean/min/max/span summary.
    The parser only stops the monitor while it runs, so stray keys cannot
    record labels mid-loop. Readouts are grouped by four, each group
    header naming the addressed ADS module and channel. README documents
    the slot monitor section and the clamp/variance checks.
2026-10-13 fix(gbox): align I2C wiring in code with physical board layout
    The prod firmware assumed the ADS1115 addresses were laid out
    sequentially 0x48..0x4B, but the physical board wires slots 1-4
    on 0x4B (ADDR->SCL) instead. Changing the code was simpler than
    re-wiring the hardware.
    Update slotBaseFor in the ADS1X15 mock, reorder kAdsDevices in
    GBox.cpp and the I2C1 probe array to 0x4B->0x48->0x4A->0x49.
    Replace the broken '0x48 + slot/4' formula in the unit test
    with an explicit address lookup table.
2026-10-13 feat(hw-test): add guided calibration game mode
    Implement a step-by-step calibration wizard that walks through all
    piece/slot combinations (5 pieces x 4 slots x 8 samples = 160 steps).
    Key features:
    - Stability check (5 reads, span < 100) before recording
    - Outlier guard (+-20%) to reject misplacements
    - Bulk EMPTY recording for all slots at once (single SPACE press)
    - Clear transition messages when changing slots or pieces
    - Automatic threshold generation at end (midpoints between classes)
    - Game mode help via '?' key
    Also update piece_thresholds.h with real calibrated 16-bit values
    from the campaign and reorder kAdcDecodeTable in GBox.cpp to match
    the measured ascending raw value order: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
2026-10-20 feat(hw-test): auto-capture in game mode to cut SPACE presses
    Game mode walked 8 samples per (piece, slot) and required one SPACE
    press each: with 12 slots that is ~385 presses. Add an auto-capture
    poll that reads the current slot in the main loop and records a sample
    as soon as the reading is stable, so the operator only places pieces.
    - gGameAuto (default ON) toggled by 'a' in game mode
    - recordGameSample() replaces attemptGameRecord() and returns a status
    enum (Recorded/Unstable/Outlier/ReadFail) so the manual SPACE path
    stays verbose while the auto poll stays quiet and retries silently
    - an outlier warns once per sample (gGameOutlierWarned) instead of on
    every poll, and leaves sta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
2026-10-27 feat(gbox): add shared DFU bootloader entry recipe
    The production board and the bench firmware now jump to the STM32
    DFU bootloader the same way, through a shared dfu_bootloader.h: type
    "dfu" on the serial port, no button needed. The scan header prints
    the EMPTY threshold while dropping the unused LOOP_END column.
2026-10-27 docs(hardware): redraw the box schematic
    The ADS1115 modules move to positions that make the wiring and the
    soldering simpler. The schematic is redrawn to match the new layout.
2026-10-27 feat(hw-test): echo typed keys, blink heartbeat LED, write the README
    Typed keys echo back so the operator is never blind on a silent
    terminal, the heartbeat blinks from a properly declared output, and
    the README documents the campaign toolchain, the dfu jump and the
    runtime modes.
2026-10-27 fix(hw-test): correct threshold scan and cluster import bugs
    Each slot prints its own threshold row in the calibration scan, the
    cluster dump moves to the D key to free the dfu word, and pasted
    import lines end on CR as well as LF.
2026-10-27 refactor(hw-test): split main.cpp into one file per feature
    The 2600-line main.cpp becomes one file per concern: ads probing, led
    animations, label clusters, guided game mode, scan and slot monitor,
    usb shell. Layout only, no behavior change.
2026-10-27 feat(hw-test): per-slot retakes, live decoding, remove obsolete tools
    A game campaign can be scoped to one slot or one piece, the slot
    monitor decodes every reading live against the slot's own row, and
    the global-table tools the per-slot table made obsolete are dropped.
2026-10-27 feat(hw-test): add freeze mode per slot
    One clean measurement per keystroke: the slot waits without sampling
    and SPACE opens a fixed 3 s window whose stats print as a single
    self-contained line, so rotating the piece between two measures
    cannot pollute any stat.
2026-10-27 refactor(hw-test): rename slot columns to avoid confusion
    Band 1 still carried its historical BACKWARD name although the loop
    piece plays there: the column is now COL_LOOP_START. The 0xFFFF
    sentinel above FORWARD becomes COL_TO_REMOVE: the name admits the
    column is temporary and will be dropped as soon as the production
    migration moves GBox.cpp onto the per-slot table. Names only, no
    decode behavior change.
2026-10-27 chore(hw-test): round the calibration threshold values
    The thresholds are now round numbers, easier to read and edit.
    The blue band starts lower: a blue piece seated a bit deeper is
    now detected instead of showing INVALID.
2026-10-27 fix(hw-test): retry the i2c probe on miss after rail power-up
    The health probe ran 250 ms after the 3V3 rail power-up and gave each
    module a single bare transaction: the four I2C1 modules, still coming
    up behind the rail, missed together while answering fine seconds
    later in the test pass. A miss is now retried twice with 200 ms
    pauses, and the quiet change report uses the same primitive.
2026-10-27 feat: move led/button pins to PB8/PB9 and extend the walk to 20 slots
    The board is fully populated now, so the guided walk covers all 20
    slots and every row gets placeholder thresholds copied from the
    closest calibrated slot until its own campaign. The led strip and
    the wake button move to PB8/PB9 following the board rewire, with the
    emulator pin table adapted, and the floating-channels disclaimer
    leaves the test pass.
2026-10-27 chore(hw-test): calibrate the newly soldered slots
    The eight slots soldered since the last table get their measured
    thresholds from the frozen monitor on the marked pieces, and slot 11
    sees its yellow boundary re-centered. Every row of the board now
    carries real calibration values.
2026-10-31 feat(hw-test): wait for a key instead of running the health test at boot
    The board used to launch the health cycle on its own at power-up. It
    now waits silently for a key: 's' runs the test from any mode, exactly
    as before, and '?' prints the help. The boot banner that announced the
    automatic cycle is replaced by a waiting hint.
2026-10-31 feat(hw-test): drive the soldered APA106 LEDs with FastLED
    The three APA106 status LEDs are now soldered and have been tested on the
    bench: the board moved from the NeoPixel strip to the APA106 chain, with
    Adafruit NeoPixel swapped for the FastLED library (dedicated APA106
    controller, RGB wire order measured on this batch).
    - bring the 5V rail up before the first frame (the chip ignores frames
    while unpowered) and move debug builds to -O2: the clockless bit timing
    does not survive -O0, which showed as stuck or all-white LEDs
    - add an interactive LED test menu on 'l': walk, per-LED channel check
    and the canned animations, 5V rail switched for the menu duration
    - drop the TEST_LED_ANIMA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
2026-10-31 docs(hw-test): refresh the README for the 20-slot walk, reset and boot flow
    - recount the guided game now that kGameSlotCount = 20: 800 steps instead
    of 480, forty steps for a scoped "7gg", twenty rows, and a corrected
    example session step numbering
    - document the reset command, drop the removed cluster import (i) from the
    echo paragraph, and fix the APA106 init log prefix
    - split the expected output between the boot (ends on the waiting hint)
    and the "s" cycle
    - ignore the MEDIA/ directory
2026-11-07 chore(gbox): add wake button to schematics
2026-11-07 feat(hw-test): add a deep sleep test woken by the wake button
    Mirror GBox::enterLowPowerMode(): blackout while the LED rail is still
    up, cut both rails, then STOP with the low-power regulator. Only PB9's
    FALLING EXTI restarts the chip.
    The wake path is what production lacks: USBD_SystemClockConfigFromResume()
    restores the clocks, then HAL_ResumeTick and a USB re-enumeration bring
    the CDC port back. The report shows the EXTI source and the awake time,
    three green flashes prove the wake even if USB stays away.
2026-11-07 feat(hw-test): diagnose and mask the deep sleep spurious wake
    Detach the USB device so the terminal marks the sleep entry, clear EXTI->PR
    before the __WFI() and report EXTI->IMR, SYSCFG->EXTICR[2] and PWR->CSR after
    the wake: only line 9 on GPIOB is armed, so the edge comes from PB9. A wake
    with nobody holding the button is reported as spurious and the board sleeps
    again instead of waking.
2026-11-07 perf(hw-test): drop the LED animations from the health cycle
    The power-on and power-off animations cost several seconds on every run
    of 's'. The LED menu already runs them on demand with its key 0, so the
    health cycle keeps the rails, the probes and the radio only.
