javierfileiv/gaspetto/(notices)

Notices in the files:
soft/Tests/NRFBridge/Timer.cpp:
This program is free software; you can redistribute it and/or modify
it under the terms of the GNU General Public License as published by
the Free Software Foundation; either version 2 of the License, or
(at your option) any later version.
kicad/prototipo-stm32-nrf24l01/prototipo_gaspetto_car.kicad_sch:
Symbol license: LGPL v3
